erdemts/CanGateway/doc/Proje Detayları.docx

sysData.ioCheckDebounceTimer

sysData.currentDoorStates.DOOR_STATES.DOOR_1_STATE

sysData.SystemDoorCount

sensorList[count].START_COUNTING_QUERY_TRY_COUNT;

sysData.currentDoorStates.door_states

sysData.oldDoorStates.door_states

sysData.All_Doors_Closed

sysData.CAT_1_IN_TOTAL

sysData.currentDoorStates.DOOR_STATES.DOOR_1_STATE

,
