erdemts/CanGateway/doc/Tasarım Notları.docx

# 1. HARDWARE

  1.1. GPS
  1.2. SPI Flash (Sayısı ve özellikleri belirlenecek.)
  1.3. EEProm (2 adet 1 Mb ve 2 Mb uyumlu olacak.)
  1.4. 6x Digital Input (Girişlerden biri Input Capture özellikli olacak. Diğerleri On pin change özellikli olacak.)
  1.5. 2x Digital Output (TTL)
  1.6. 1x Relay
  1.7. Ethernet Modül
  1.8. 2x CanBus
  1.9. 1x RS232 (Bootloader)
  1.10. 1x RS485 (Kifi için)
  1.11. 1x SDCard
  1.12. 1x Uart Extension

Not: PIC32MX512F795L pin 68, 69, 70 Input Capture özelliklidir.

# 2. SOFTWARE

## 2.1. LOGLANMASI GEREKEN BİLGİLER

    2.1.1. Sensöre ulaşılamıyor.
    2.1.2. Sensor status.
    2.1.3. Veri gönderilemedi.
    2.1.4. Enerji geldi, gitti, düşük voltaj.
    2.1.5. Sensör diğer hatalar.
    2.1.6. Periyodik durum mesajı.

## 2.2. LOG YAPISI

    2.2.1. Tarih
    2.2.2. Saat
    2.2.3. Log Tipi
    2.2.4. Log Verisi

## 1. YOLCU SAYMA VERİSİ

Yolcu sayma verisi her kapı için ayrı ayrı gönderilir. Kapı açıldığında sayıma başlanır. Kapı kapatıldığında aşağıdaki formatta sayım verisi gönderilir.

  2.3. Kapı No 1 Byte (0,1,2)
  2.4. Kapının açılma zamanı 4 Byte (time_t)
  2.5. Kapının kapanma zamanı 4 Byte (time_t)
  2.6. Kategori 1 Binen Yolcu Sayısı 1 Byte
  2.7. Kategori 1 İnen Yolcu Sayısı 1 Byte
  2.8. Kategori 2 Binen Yolcu Sayısı 1 Byte
  2.9. Kategori 2 İnen Yolcu Sayısı 1 Byte

Toplam 13 byte.

typedef struct {

unsigned char doorNo;

time_t openTime;

time_t closeTime;

unsigned char Cat_1_In;

unsigned char Cat_1_Out;

unsigned char Cat_2_In;

unsigned char Cat_2_Out;

} COUNT_DATA_BUFFER_TYPE;

## 3. STATUS VERİSİ

Sensör veya canbus durum değişkenlerinde bir değişiklik olduğunda gönderilir.

  3.1. Zaman bilgisi 4Byte
  3.2. Status Tipi: Sensör veya Canbus statusu 1 Byte
  3.3. Kapı No: Sadece sensör status tipinde anlamlıdır. 1 Byte
  3.4. Status değişkeni 2 Byte

typedef struct {

time_t currentTime;

unsigned char statusType;

unsigned char doorNo;

unsigned short status;

} STATUS_DATA_BUFFER_TYPE;
