erdemts/CanGateway/Hardware/INNO_CAN/INNO_CAN_V1.1.brd

## EAGLE design Hardware/INNO_CAN/INNO_CAN_V1.1.brd (2018-05-25)

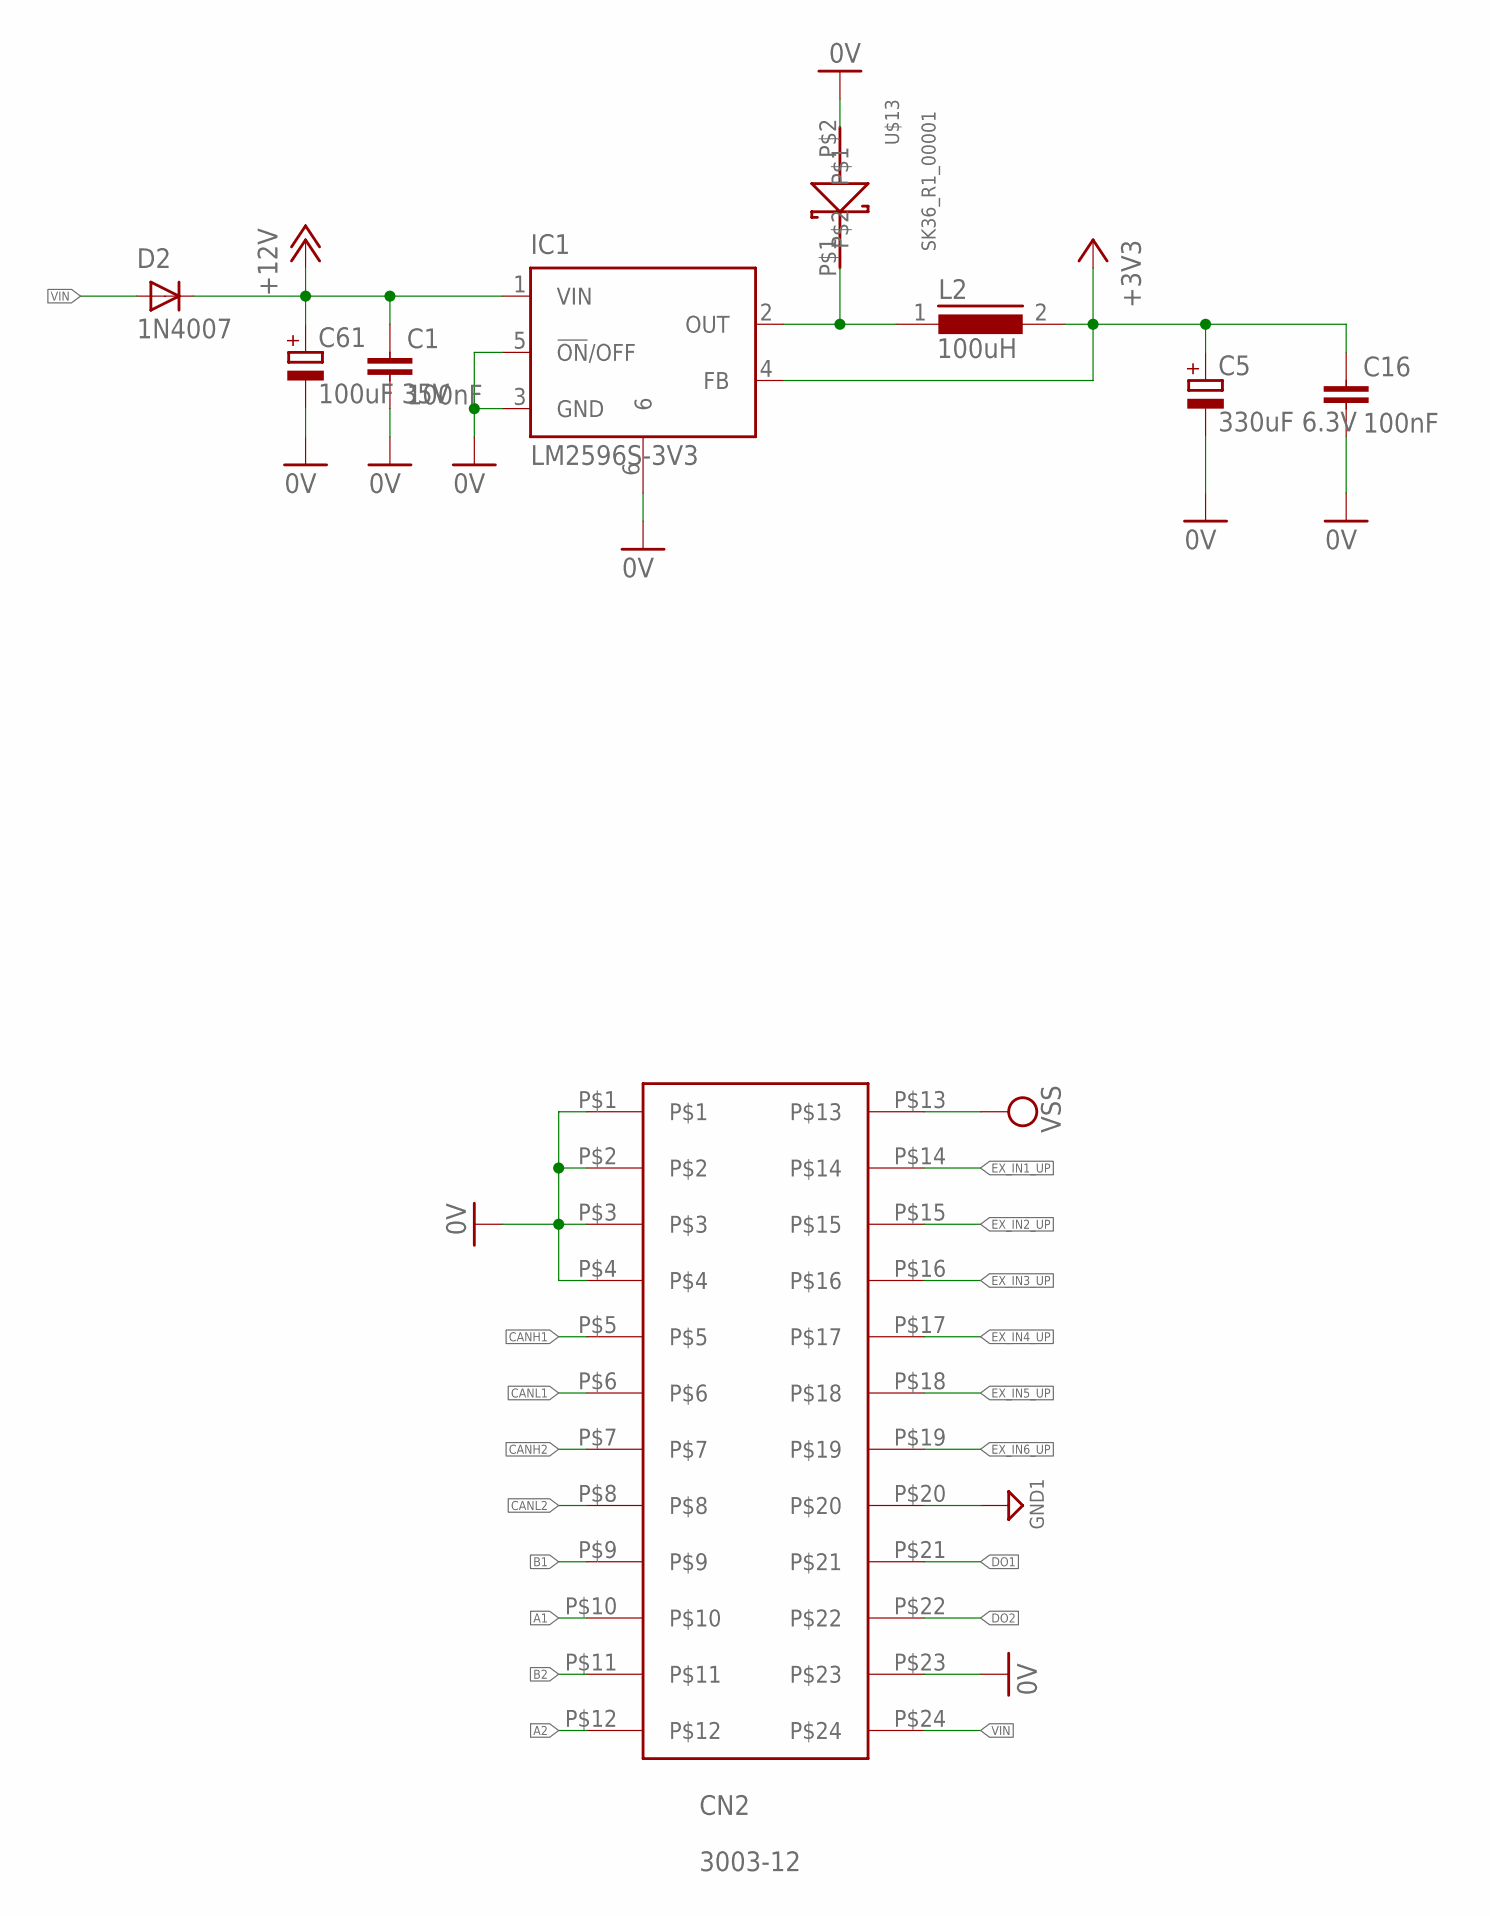
[picture p2: schematic INNO_CAN_V1.1.sch, sheet 1, POWER LAYER]

Parts:
C1, C16: 100nF; C0603
C5: 330uF 6.3V; E2,5-6
C61: 100uF 35V; E5-6
CN2: 3003-12
D2: 1N4007; SMA-DO214AC
IC1: LM2596S-3V3; TO263-5
L2: 100uH; DR127
U$13: SK36_R1_00001; SMC

Connections:
0V: C1.2, C5.-, C16.2, C61.-, CN2.P$1, CN2.P$2, CN2.P$3, CN2.P$4, CN2.P$23, IC1.3 (GND), IC1.5 (!ON!/OFF), IC1.6, U$13.P$2; also elsewhere on the board
+3V3: C5.+, C16.1, IC1.4 (FB), L2.2; also elsewhere on the board
+12V: C1.1, C61.+, D2.K (C), IC1.1 (VIN); also elsewhere on the board
A1: CN2.P$10; also elsewhere on the board
A2: CN2.P$12; also elsewhere on the board
B1: CN2.P$9; also elsewhere on the board
B2: CN2.P$11; also elsewhere on the board
CANH1: CN2.P$5; also elsewhere on the board
CANH2: CN2.P$7; also elsewhere on the board
CANL1: CN2.P$6; also elsewhere on the board
CANL2: CN2.P$8; also elsewhere on the board
DO1: CN2.P$21; also elsewhere on the board
DO2: CN2.P$22; also elsewhere on the board
EX_IN1_UP: CN2.P$14; also elsewhere on the board
EX_IN2_UP: CN2.P$15; also elsewhere on the board
EX_IN3_UP: CN2.P$16; also elsewhere on the board
EX_IN4_UP: CN2.P$17; also elsewhere on the board
EX_IN5_UP: CN2.P$18; also elsewhere on the board
EX_IN6_UP: CN2.P$19; also elsewhere on the board
GND1: CN2.P$20; also elsewhere on the board
unnamed: IC1.2 (OUT), L2.1, U$13.P$1
VIN: CN2.P$24, D2.A
VSS: CN2.P$13; also elsewhere on the board

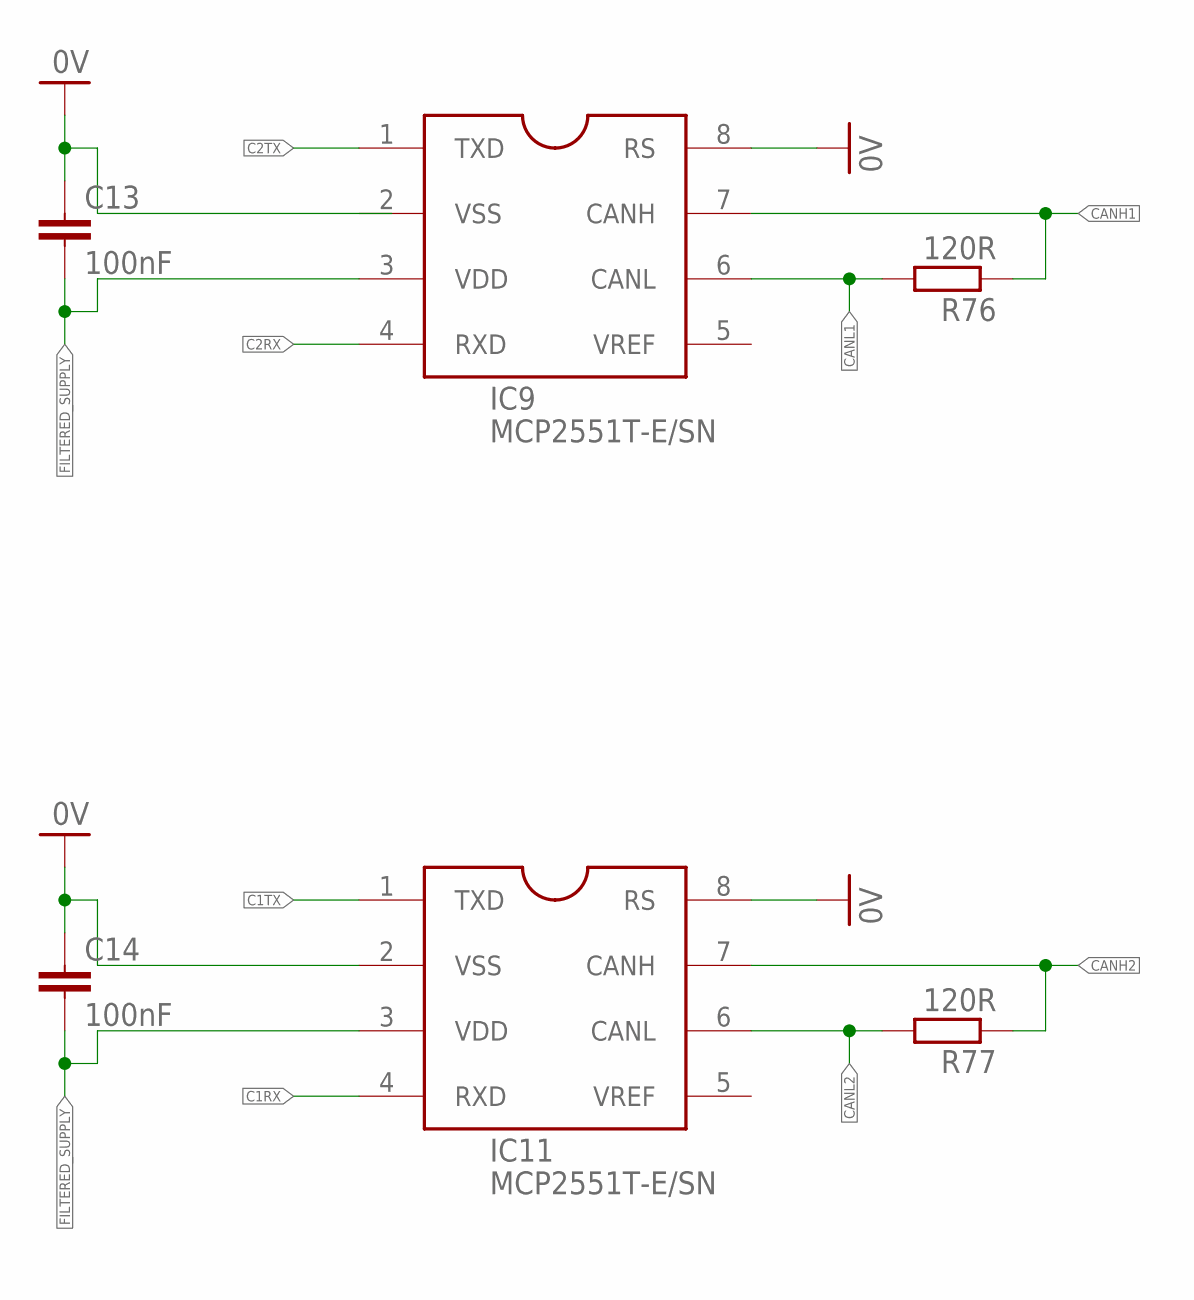
[picture p3: schematic INNO_CAN_V1.1.sch, sheet 2, CAN LAYER]

Parts:
C13, C14: 100nF; C0603K
IC9, IC11: MCP2551T-E/SN; SOIC08
R76, R77: 120R; R0603

Connections:
0V: C13.1, C14.1, IC9.8 (RS), IC11.2 (VSS), IC11.8 (RS); also elsewhere on the board
C1RX: IC11.4 (RXD); also elsewhere on the board
C1TX: IC11.1 (TXD); also elsewhere on the board
C2RX: IC9.4 (RXD); also elsewhere on the board
C2TX: IC9.1 (TXD); also elsewhere on the board
CANH1: IC9.7 (CANH), R76.1; also elsewhere on the board
CANH2: IC11.7 (CANH), R77.1; also elsewhere on the board
CANL1: IC9.6 (CANL), R76.2; also elsewhere on the board
CANL2: IC11.6 (CANL), R77.2; also elsewhere on the board
FILTERED_SUPPLY: C13.2, C14.2, IC9.3 (VDD), IC11.3 (VDD); also elsewhere on the board

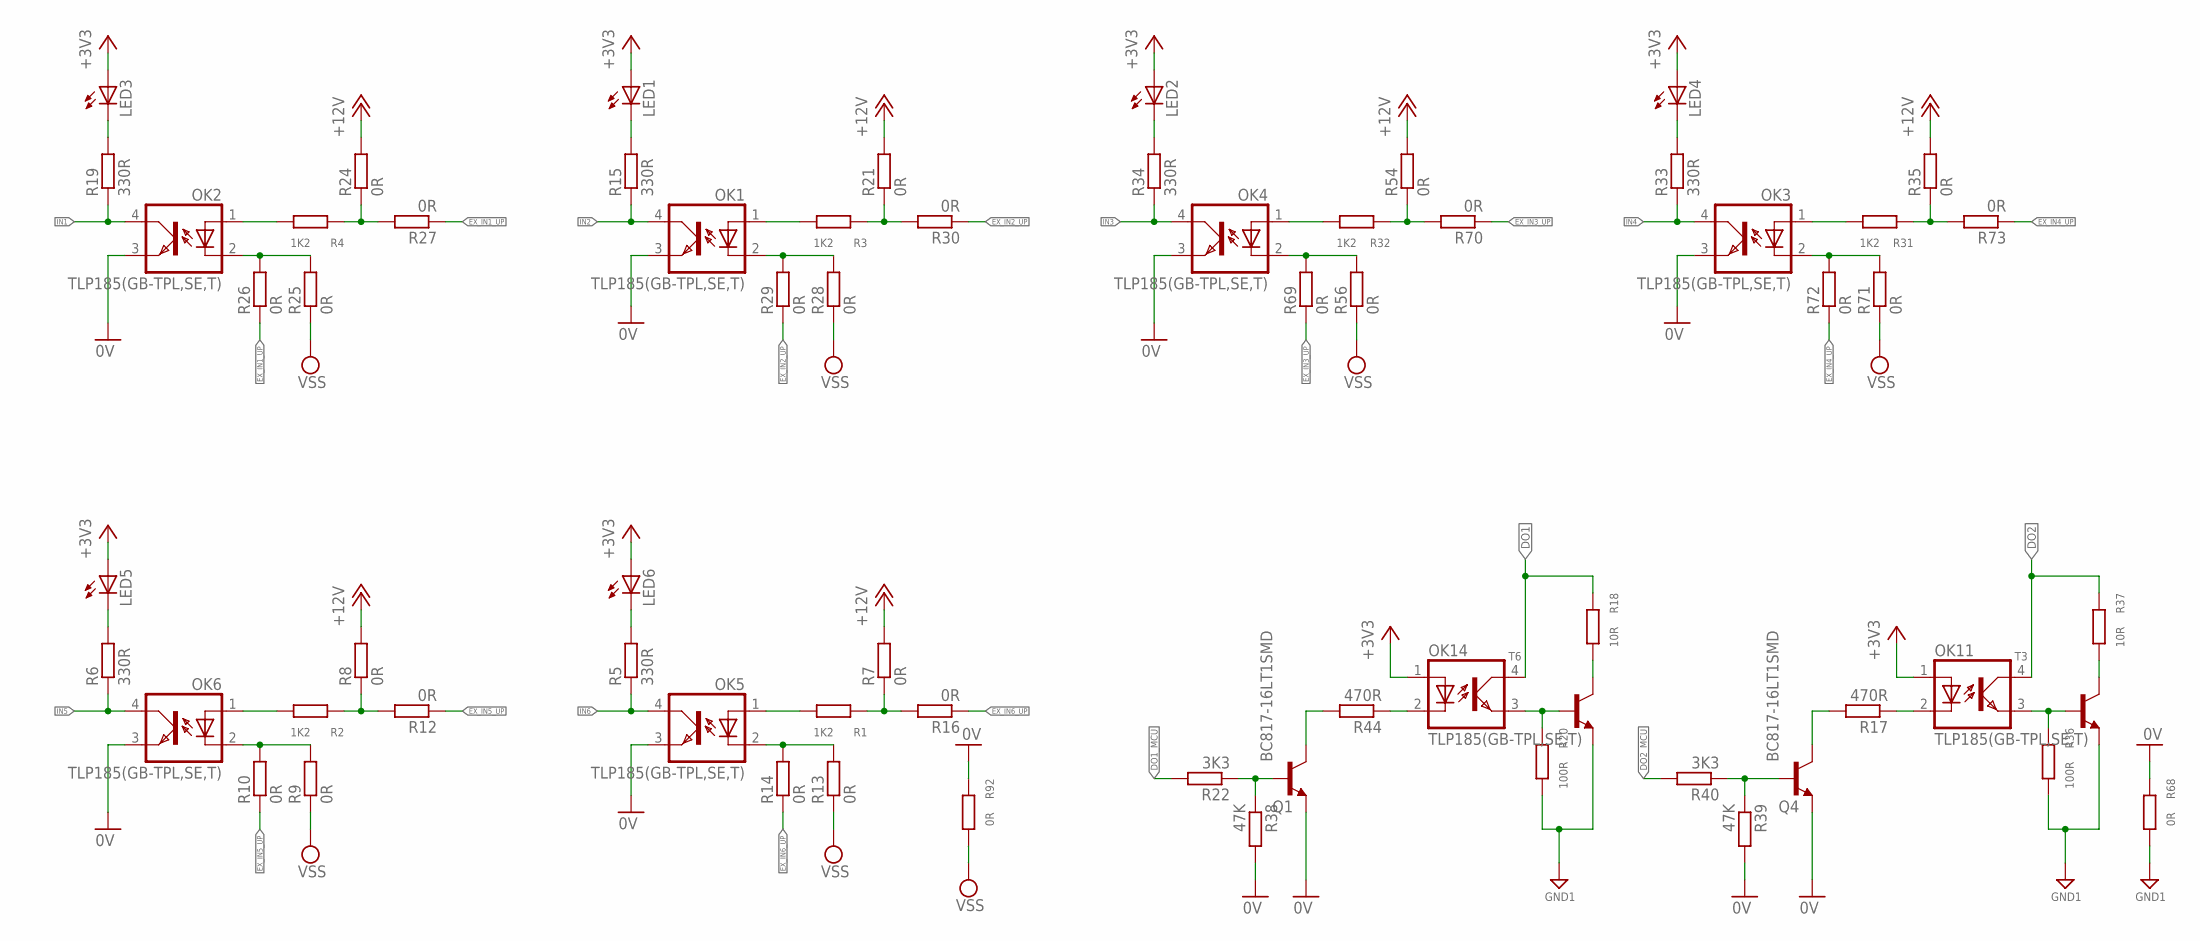
[picture p4: schematic INNO_CAN_V1.1.sch, sheet 3, PERIPHERLAS]

Parts:
LED1, LED2, LED3, LED4, LED5, LED6: LEDCHIPLED_0805; CHIPLED_0805
OK1, OK2, OK3, OK4, OK5, OK6, OK11, OK14: TLP185(GB-TPL,SE,T); SMD4
Q1, Q4: BC817-16LT1SMD; SOT23-BEC
R1, R2, R3, R4, R31, R32: 1K2; M0805
R5, R6, R15, R19, R33, R34: 330R; R0603
R7, R8, R9, R10, R12, R13, R14, R16, R21, R24, R25, R26, R27, R28, R29, R30, R35, R54, R56, R69, R70, R71, R72, R73: 0R; R0603
R17, R44: 470R; R0603
R18, R37: 10R; M0805
R20, R36: 100R; M0805
R22, R40: 3K3; R0603
R38, R39: 47K; R0603
R68, R92: 0R; M0805
T3, T6: BC817-16LT1-NPN-SOT23-BEC; SOT23-BEC

Connections:
0V: OK1.3 (EMIT), OK2.3 (EMIT), OK3.3 (EMIT), OK4.3 (EMIT), OK5.3 (EMIT), OK6.3 (EMIT), Q1.E, Q4.E, R38.2, R39.2, R68.1, R92.1; also elsewhere on the board
+3V3: LED1.A, LED2.A, LED3.A, LED4.A, LED5.A, LED6.A, OK11.1 (A), OK14.1 (A); also elsewhere on the board
+12V: R7.2, R8.2, R21.2, R24.2, R35.2, R54.2; also elsewhere on the board
DO1: OK14.4 (COL), R18.1; also elsewhere on the board
DO1_MCU: R22.2; also elsewhere on the board
DO2: OK11.4 (COL), R37.1; also elsewhere on the board
DO2_MCU: R40.2; also elsewhere on the board
EX_IN0_UP1: R3.1, R21.1, R30.2
EX_IN0_UP2: R31.1, R35.1, R73.2
EX_IN0_UP3: R1.1, R7.1, R16.2
EX_IN1_UP: R26.1, R27.1; also elsewhere on the board
EX_IN1_UP1: R4.1, R24.1, R27.2
EX_IN1_UP2: R32.1, R54.1, R70.2
EX_IN1_UP3: R2.1, R8.1, R12.2
EX_IN2_UP: R29.1, R30.1; also elsewhere on the board
EX_IN3_UP: R69.1, R70.1; also elsewhere on the board
EX_IN4_UP: R72.1, R73.1; also elsewhere on the board
EX_IN5_UP: R10.1, R12.1; also elsewhere on the board
EX_IN6_UP: R14.1, R16.1; also elsewhere on the board
GND1: R20.2, R36.2, R68.2, T3.E, T6.E; also elsewhere on the board
IN1: OK2.4 (COL), R19.1; also elsewhere on the board
IN2: OK1.4 (COL), R15.1; also elsewhere on the board
IN3: OK4.4 (COL), R34.1; also elsewhere on the board
IN4: OK3.4 (COL), R33.1; also elsewhere on the board
IN5: OK6.4 (COL), R6.1; also elsewhere on the board
IN6: OK5.4 (COL), R5.1; also elsewhere on the board
unnamed: OK1.1 (A), R3.2
unnamed: OK5.1 (A), R1.2
unnamed: OK2.1 (A), R4.2
unnamed: OK6.1 (A), R2.2
unnamed: OK2.2 (C), R25.2, R26.2
unnamed: OK6.2 (C), R9.2, R10.2
unnamed: OK5.2 (C), R13.2, R14.2
unnamed: OK1.2 (C), R28.2, R29.2
unnamed: LED5.C, R6.2
unnamed: LED6.C, R5.2
unnamed: OK11.2 (C), R17.1
unnamed: R37.2, T3.C
unnamed: OK11.3 (EMIT), R36.1, T3.B
unnamed: Q1.C, R44.2
unnamed: Q4.C, R17.2
unnamed: Q1.B, R22.1, R38.1
unnamed: OK3.1 (A), R31.2
unnamed: Q4.B, R39.1, R40.1
unnamed: OK4.1 (A), R32.2
unnamed: OK4.2 (C), R56.2, R69.2
unnamed: OK3.2 (C), R71.2, R72.2
unnamed: LED3.C, R19.2
unnamed: LED1.C, R15.2
unnamed: LED2.C, R34.2
unnamed: LED4.C, R33.2
unnamed: OK14.2 (C), R44.1
unnamed: R18.2, T6.C
unnamed: OK14.3 (EMIT), R20.1, T6.B
VSS: R9.1, R13.1, R25.1, R28.1, R56.1, R71.1, R92.2; also elsewhere on the board

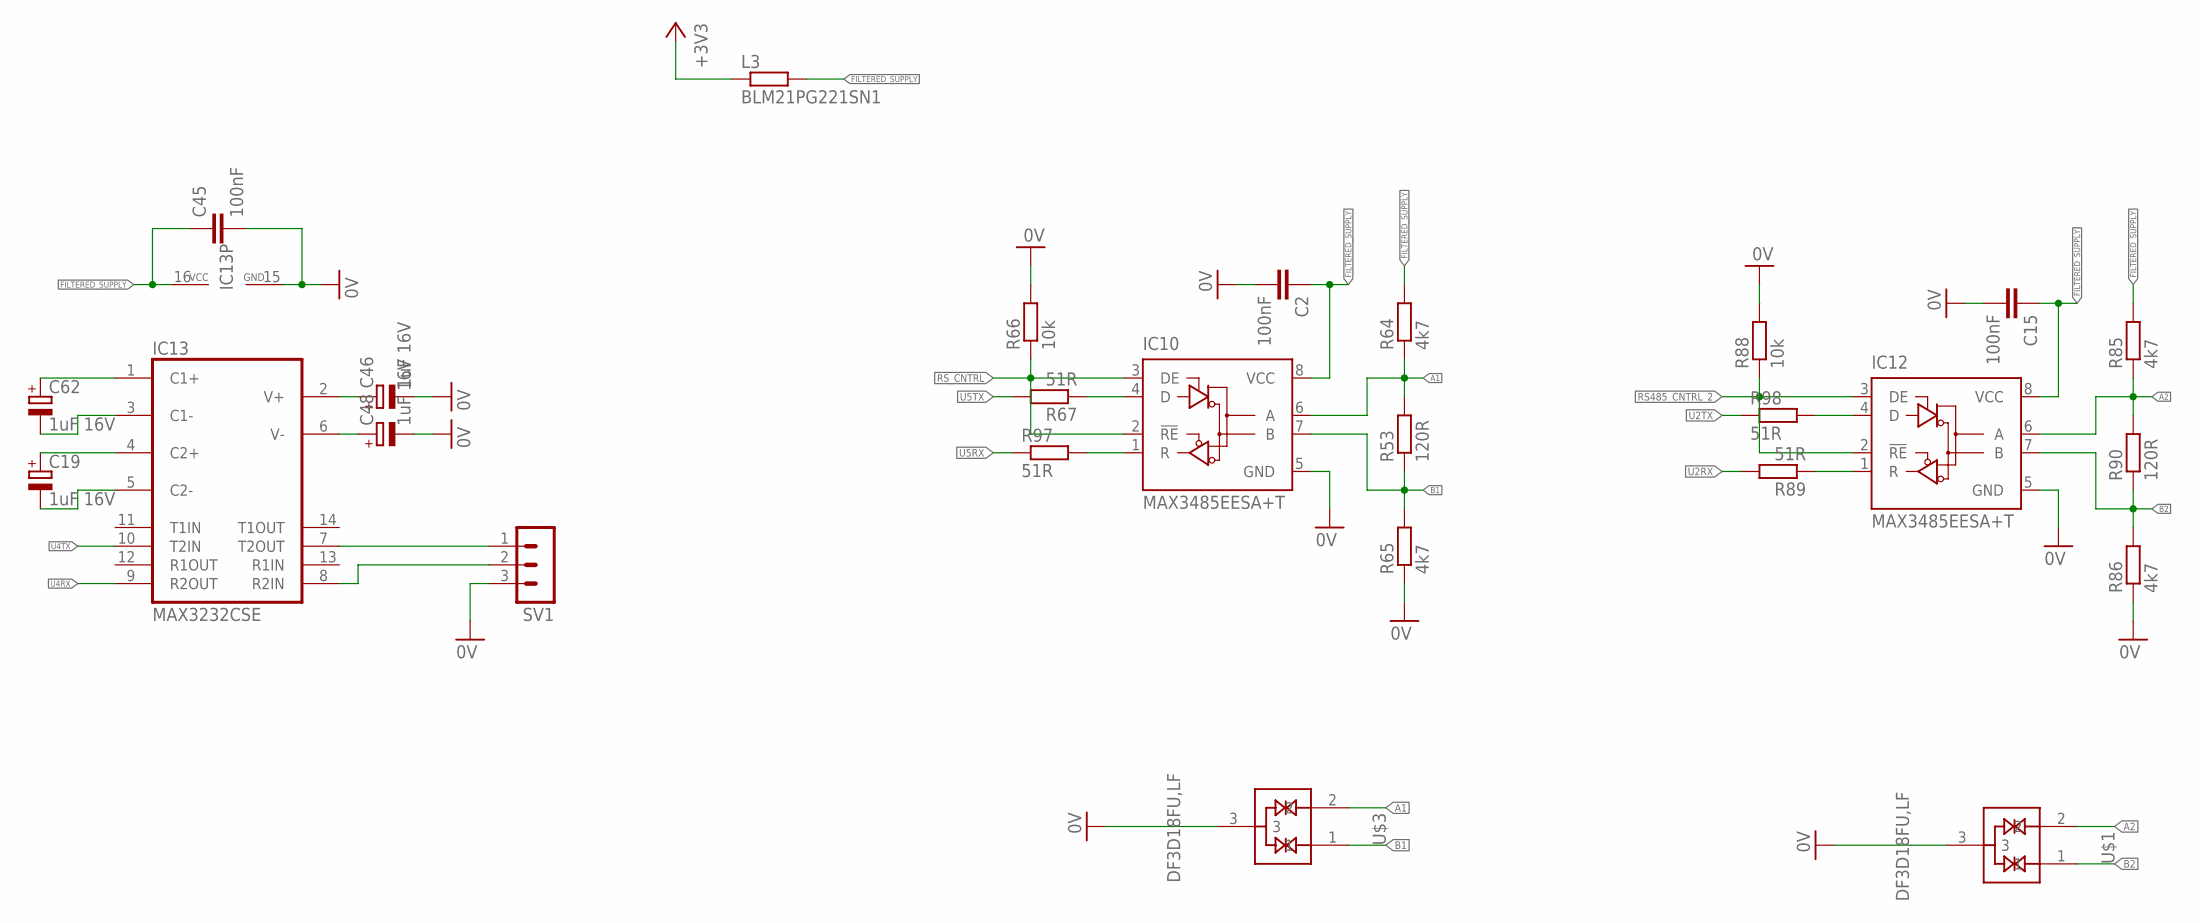
[picture p5: schematic INNO_CAN_V1.1.sch, sheet 4, RS-232 && RS-485]

Parts:
C2, C15, C45: 100nF; C0603
C19, C46, C48, C62: 1uF 16V; SMC_Z
IC10, IC12: MAX3485EESA+T; D_R-PDSO-G8
IC13: MAX3232CSE; SO16
L3: BLM21PG221SN1; R0805
R53, R90: 120R; R0603
R64, R65, R85, R86: 4k7; R0603
R66, R88: 10k; R0603
R67, R89, R97, R98: 51R; R0603
SV1: MA03-1
U$1, U$3: DF3D18FU,LF; SOT323

Connections:
0V: C2.2, C15.2, C45.2, C46.-, C48.-, IC10.5 (GND), IC12.5 (GND), IC13.15 (GND), R65.1, R66.2, R86.1, R88.2, SV1.3, U$1.3, U$3.3; also elsewhere on the board
+3V3: L3.1; also elsewhere on the board
A1: IC10.6 (A), R53.2, R64.1, U$3.2; also elsewhere on the board
A2: IC12.6 (A), R85.1, R90.2, U$1.2; also elsewhere on the board
B1: IC10.7 (B), R53.1, R65.2, U$3.1; also elsewhere on the board
B2: IC12.7 (B), R86.2, R90.1, U$1.1; also elsewhere on the board
FILTERED_SUPPLY: C2.1, C15.1, C45.1, IC10.8 (VCC), IC12.8 (VCC), IC13.16 (VCC), L3.2, R64.2, R85.2; also elsewhere on the board
unnamed: C62.-, IC13.3 (C1-)
unnamed: C19.+, IC13.4 (C2+)
unnamed: C46.+, IC13.2 (V+)
unnamed: C48.+, IC13.6 (V-)
unnamed: C62.+, IC13.1 (C1+)
unnamed: IC13.7 (T2OUT), SV1.1
unnamed: IC13.8 (R2IN), SV1.2
unnamed: C19.-, IC13.5 (C2-)
unnamed: IC10.1 (R), R97.2
unnamed: IC10.4 (D), R67.1
unnamed: IC12.1 (R), R89.1
unnamed: IC12.4 (D), R98.2
RS485_CNTRL_2: IC12.2 (!RE), IC12.3 (DE), R88.1; also elsewhere on the board
RS_CNTRL: IC10.2 (!RE), IC10.3 (DE), R66.1; also elsewhere on the board
U2RX: R89.2; also elsewhere on the board
U2TX: R98.1; also elsewhere on the board
U4RX: IC13.9 (R2OUT); also elsewhere on the board
U4TX: IC13.10 (T2IN); also elsewhere on the board
U5RX: R97.1; also elsewhere on the board
U5TX: R67.2; also elsewhere on the board

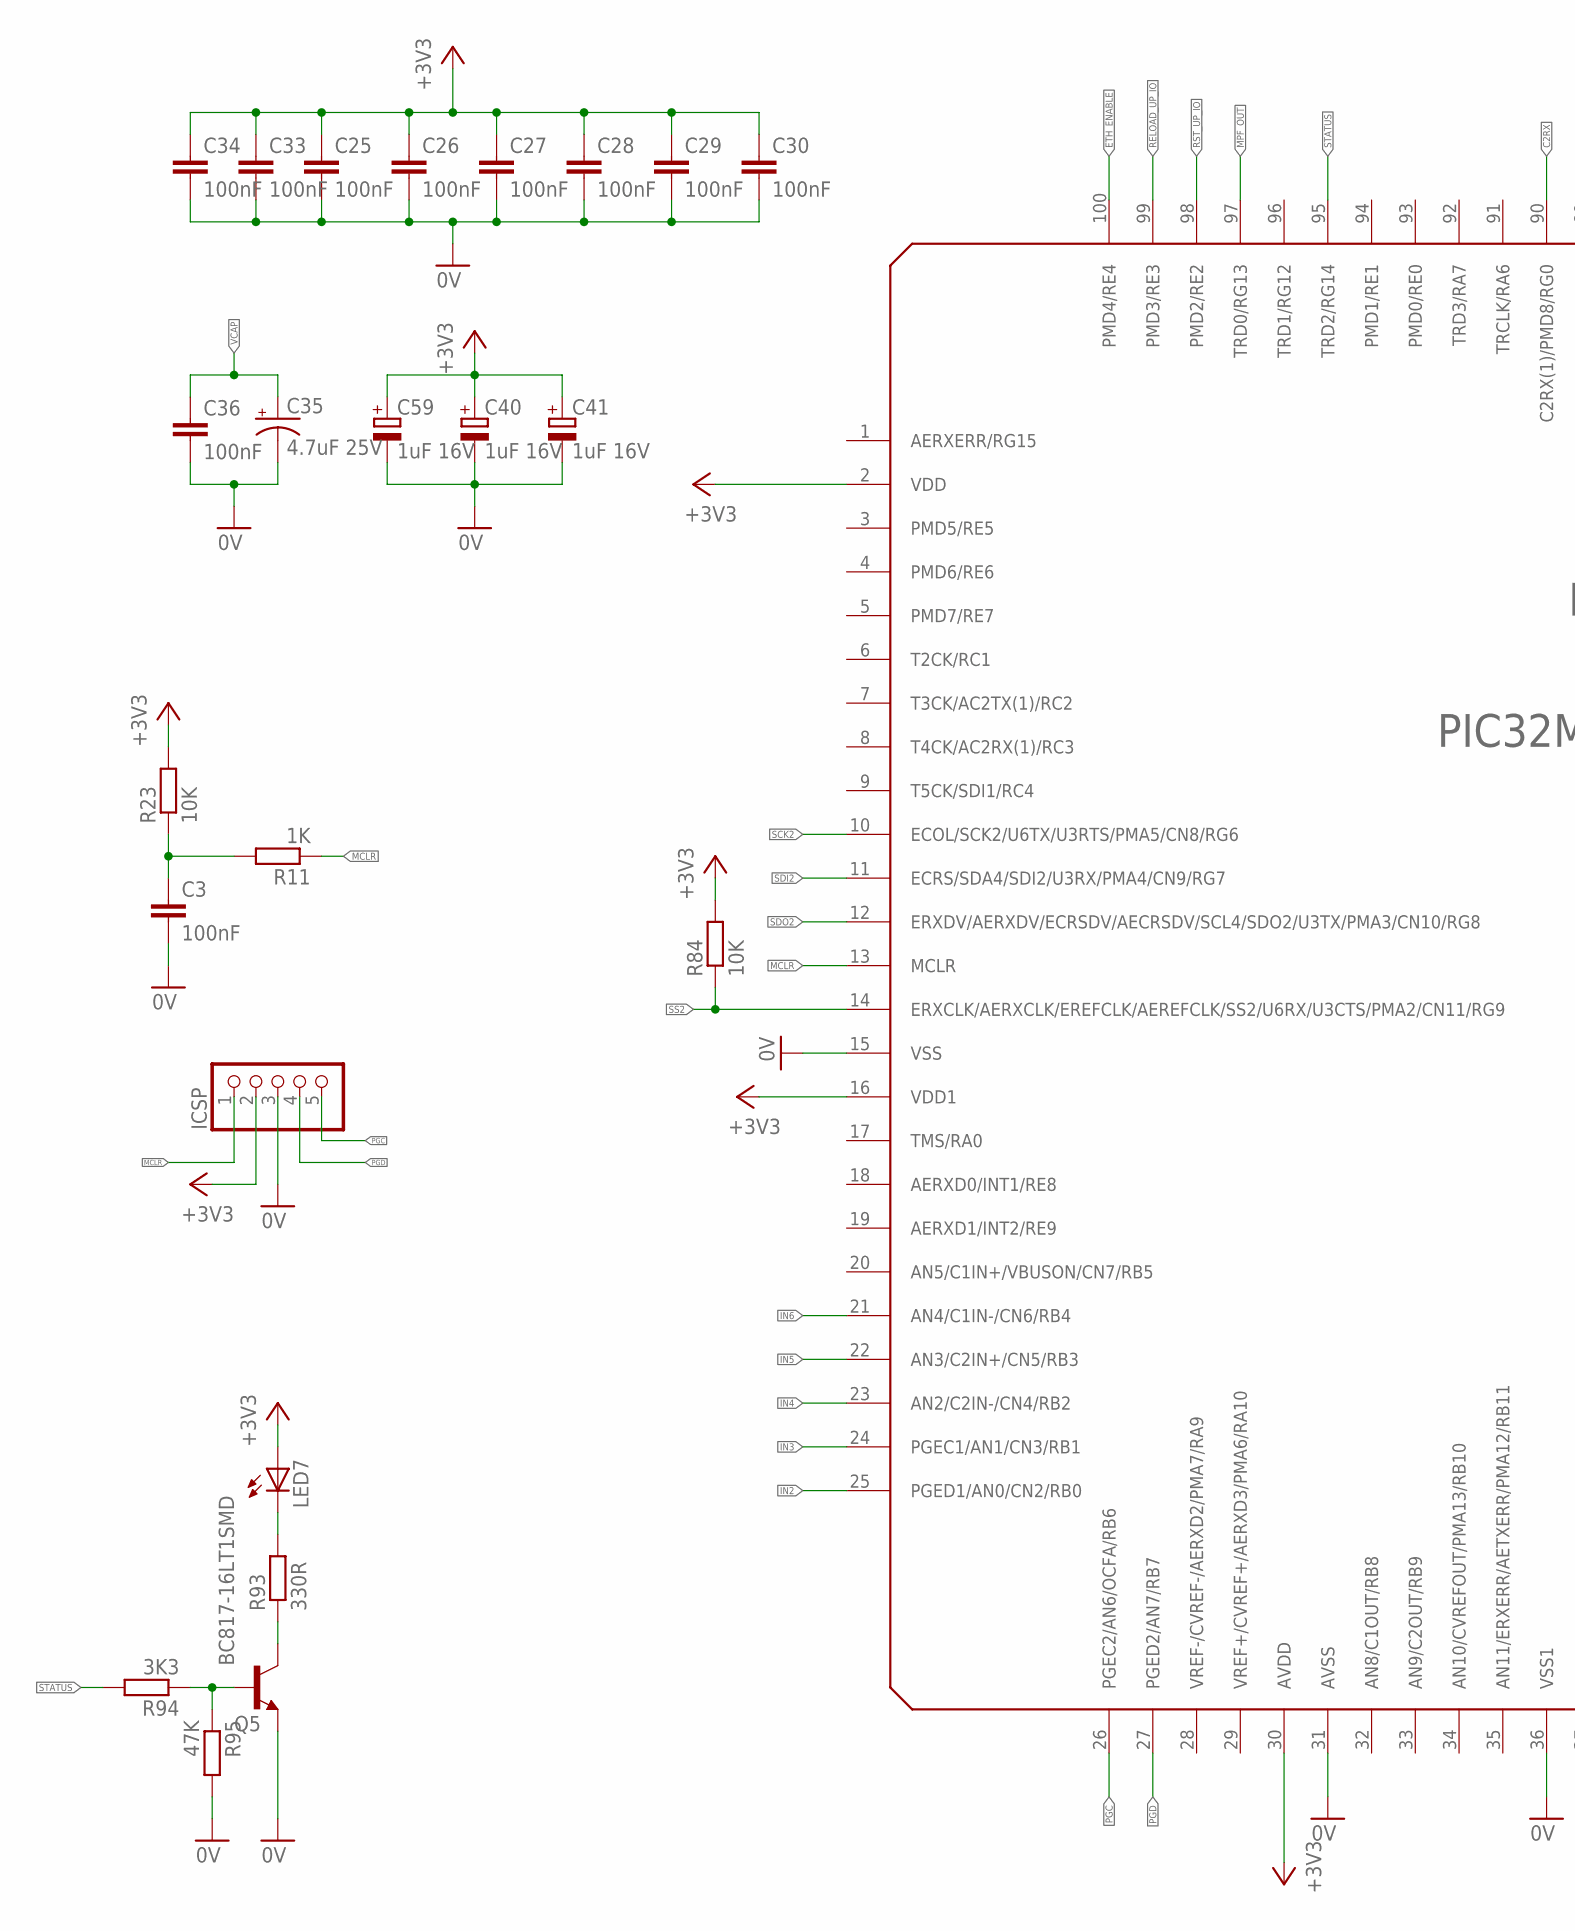
[picture p6: schematic INNO_CAN_V1.1.sch, sheet 5, MCU CONECTIONS, part in row 1, column 1]

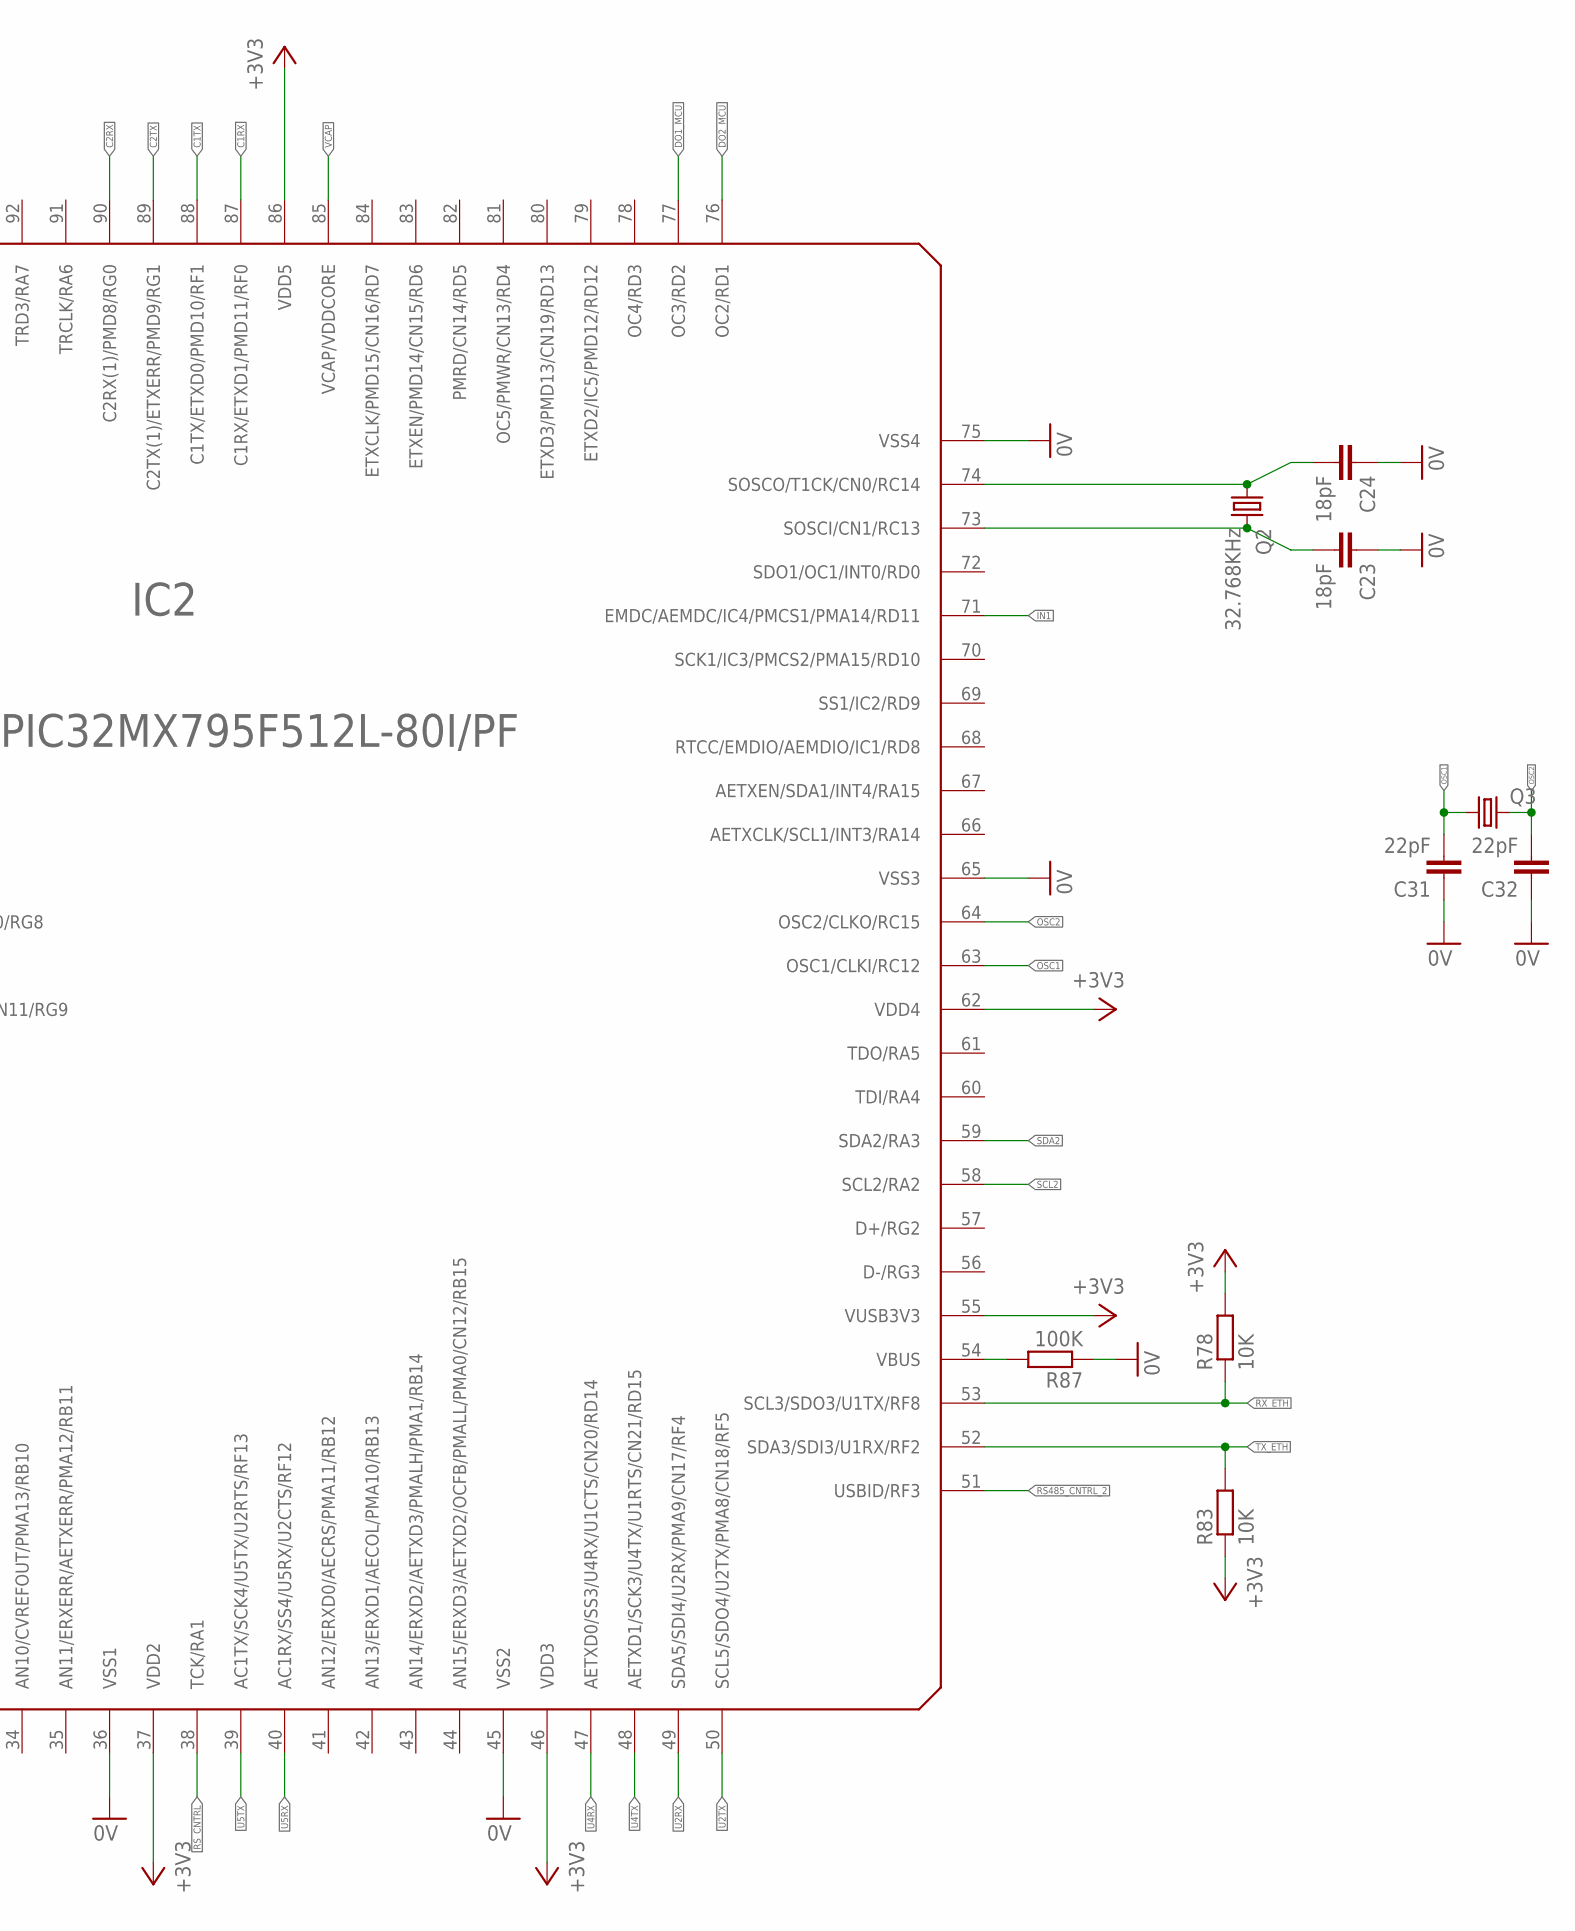
[picture p7: schematic INNO_CAN_V1.1.sch, sheet 5, MCU CONECTIONS, part in row 1, column 2]

Parts:
C3, C25, C26, C27, C28, C29, C30, C33, C34: 100nF; C0603K
C23, C24: 18pF; C0603
C31, C32: 22pF; C0805
C35: 4.7uF 25V; A/3216-18R
C36: 100nF; C0603
C40, C41, C59: 1uF 16V; SMC_Z
IC2: PIC32MX795F512L-80I/PF; TQFP100-14X14
ICSP: PINHD-1X5; 1X05
LED7: LEDCHIPLED_0805; CHIPLED_0805
Q2: 32.768KHz; TC26V
Q3: CRYSTALHC49UP; HC49UP
Q5: BC817-16LT1SMD; SOT23-BEC
R11: 1K; R0603
R23, R78, R83, R84: 10K; R0603
R87: 100K; R0603
R93: 330R; R0603
R94: 3K3; R0603
R95: 47K; R0603

Connections:
0V: C3.2, C23.1, C24.1, C25.2, C26.2, C27.2, C28.2, C29.2, C30.2, C31.1, C32.1, C33.2, C34.2, C35.-, C36.2, C40.-, C41.-, C59.-, IC2.15 (VSS), IC2.31 (AVSS), IC2.36 (VSS1), IC2.45 (VSS2), IC2.65 (VSS3), IC2.75 (VSS4), ICSP.3, Q5.E, R87.1, R95.2; also elsewhere on the board
+3V3: C25.1, C26.1, C27.1, C28.1, C29.1, C30.1, C33.1, C34.1, C40.+, C41.+, C59.+, IC2.2 (VDD), IC2.16 (VDD1), IC2.30 (AVDD), IC2.37 (VDD2), IC2.46 (VDD3), IC2.55 (VUSB3V3), IC2.62 (VDD4), IC2.86 (VDD5), ICSP.2, LED7.A, R23.2, R78.2, R83.1, R84.2; also elsewhere on the board
C1RX: IC2.87 (C1RX/ETXD1/PMD11/RF0); also elsewhere on the board
C1TX: IC2.88 (C1TX/ETXD0/PMD10/RF1); also elsewhere on the board
C2RX: IC2.90 (C2RX(1)/PMD8/RG0); also elsewhere on the board
C2TX: IC2.89 (C2TX(1)/ETXERR/PMD9/RG1); also elsewhere on the board
DO1_MCU: IC2.77 (OC3/RD2); also elsewhere on the board
DO2_MCU: IC2.76 (OC2/RD1); also elsewhere on the board
ETH_ENABLE: IC2.100 (PMD4/RE4); also elsewhere on the board
IN1: IC2.71 (EMDC/AEMDC/IC4/PMCS1/PMA14/RD11); also elsewhere on the board
IN2: IC2.25 (PGED1/AN0/CN2/RB0); also elsewhere on the board
IN3: IC2.24 (PGEC1/AN1/CN3/RB1); also elsewhere on the board
IN4: IC2.23 (AN2/C2IN-/CN4/RB2); also elsewhere on the board
IN5: IC2.22 (AN3/C2IN+/CN5/RB3); also elsewhere on the board
IN6: IC2.21 (AN4/C1IN-/CN6/RB4); also elsewhere on the board
MCLR: IC2.13 (MCLR), ICSP.1, R11.1
MPF_OUT: IC2.97 (TRD0/RG13); also elsewhere on the board
unnamed: C3.1, R11.2, R23.1
unnamed: LED7.C, R93.2
unnamed: Q5.B, R94.1, R95.1
unnamed: C23.2, IC2.73 (SOSCI/CN1/RC13), Q2.2
unnamed: Q5.C, R93.1
unnamed: C24.2, IC2.74 (SOSCO/T1CK/CN0/RC14), Q2.1
unnamed: IC2.54 (VBUS), R87.2
OSC1: C31.2, IC2.63 (OSC1/CLKI/RC12), Q3.1
OSC2: C32.2, IC2.64 (OSC2/CLKO/RC15), Q3.2
PGC: IC2.26 (PGEC2/AN6/OCFA/RB6), ICSP.5
PGD: IC2.27 (PGED2/AN7/RB7), ICSP.4
RELOAD_UP_IO: IC2.99 (PMD3/RE3); also elsewhere on the board
RS485_CNTRL_2: IC2.51 (USBID/RF3); also elsewhere on the board
RST_UP_IO: IC2.98 (PMD2/RE2); also elsewhere on the board
RS_CNTRL: IC2.38 (TCK/RA1); also elsewhere on the board
RX_ETH: IC2.53 (SCL3/SDO3/U1TX/RF8), R78.1; also elsewhere on the board
SCK2: IC2.10 (ECOL/SCK2/U6TX/U3RTS/PMA5/CN8/RG6); also elsewhere on the board
SCL2: IC2.58 (SCL2/RA2); also elsewhere on the board
SDA2: IC2.59 (SDA2/RA3); also elsewhere on the board
SDI2: IC2.11 (ECRS/SDA4/SDI2/U3RX/PMA4/CN9/RG7); also elsewhere on the board
SDO2: IC2.12 (ERXDV/AERXDV/ECRSDV/AECRSDV/SCL4/SDO2/U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); also elsewhere on the board
SS2: IC2.14 (ERXCLK/AERXCLK/EREFCLK/AEREFCLK/SS2/U6R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), R84.1; also elsewhere on the board
STATUS: IC2.95 (TRD2/RG14), R94.2
TX_ETH: IC2.52 (SDA3/SDI3/U1RX/RF2), R83.2; also elsewhere on the board
U2RX: IC2.49 (SDA5/SDI4/U2RX/PMA9/CN17/RF4); also elsewhere on the board
U2TX: IC2.50 (SCL5/SDO4/U2TX/PMA8/CN18/RF5); also elsewhere on the board
U4RX: IC2.47 (AETXD0/SS3/U4RX/U1CTS/CN20/RD14); also elsewhere on the board
U4TX: IC2.48 (AETXD1/SCK3/U4TX/U1RTS/CN21/RD15); also elsewhere on the board
U5RX: IC2.40 (AC1RX/SS4/U5RX/U2CTS/RF12); also elsewhere on the board
U5TX: IC2.39 (AC1TX/SCK4/U5TX/U2RTS/RF13); also elsewhere on the board
VCAP: C35.+, C36.1, IC2.85 (VCAP/VDDCORE)
