erdemts/CanGateway/Hardware/INNO_CAN/INNO_CAN_V1.1.brd

## EAGLE design Hardware/INNO_CAN/INNO_CAN_V1.1.brd (continued)

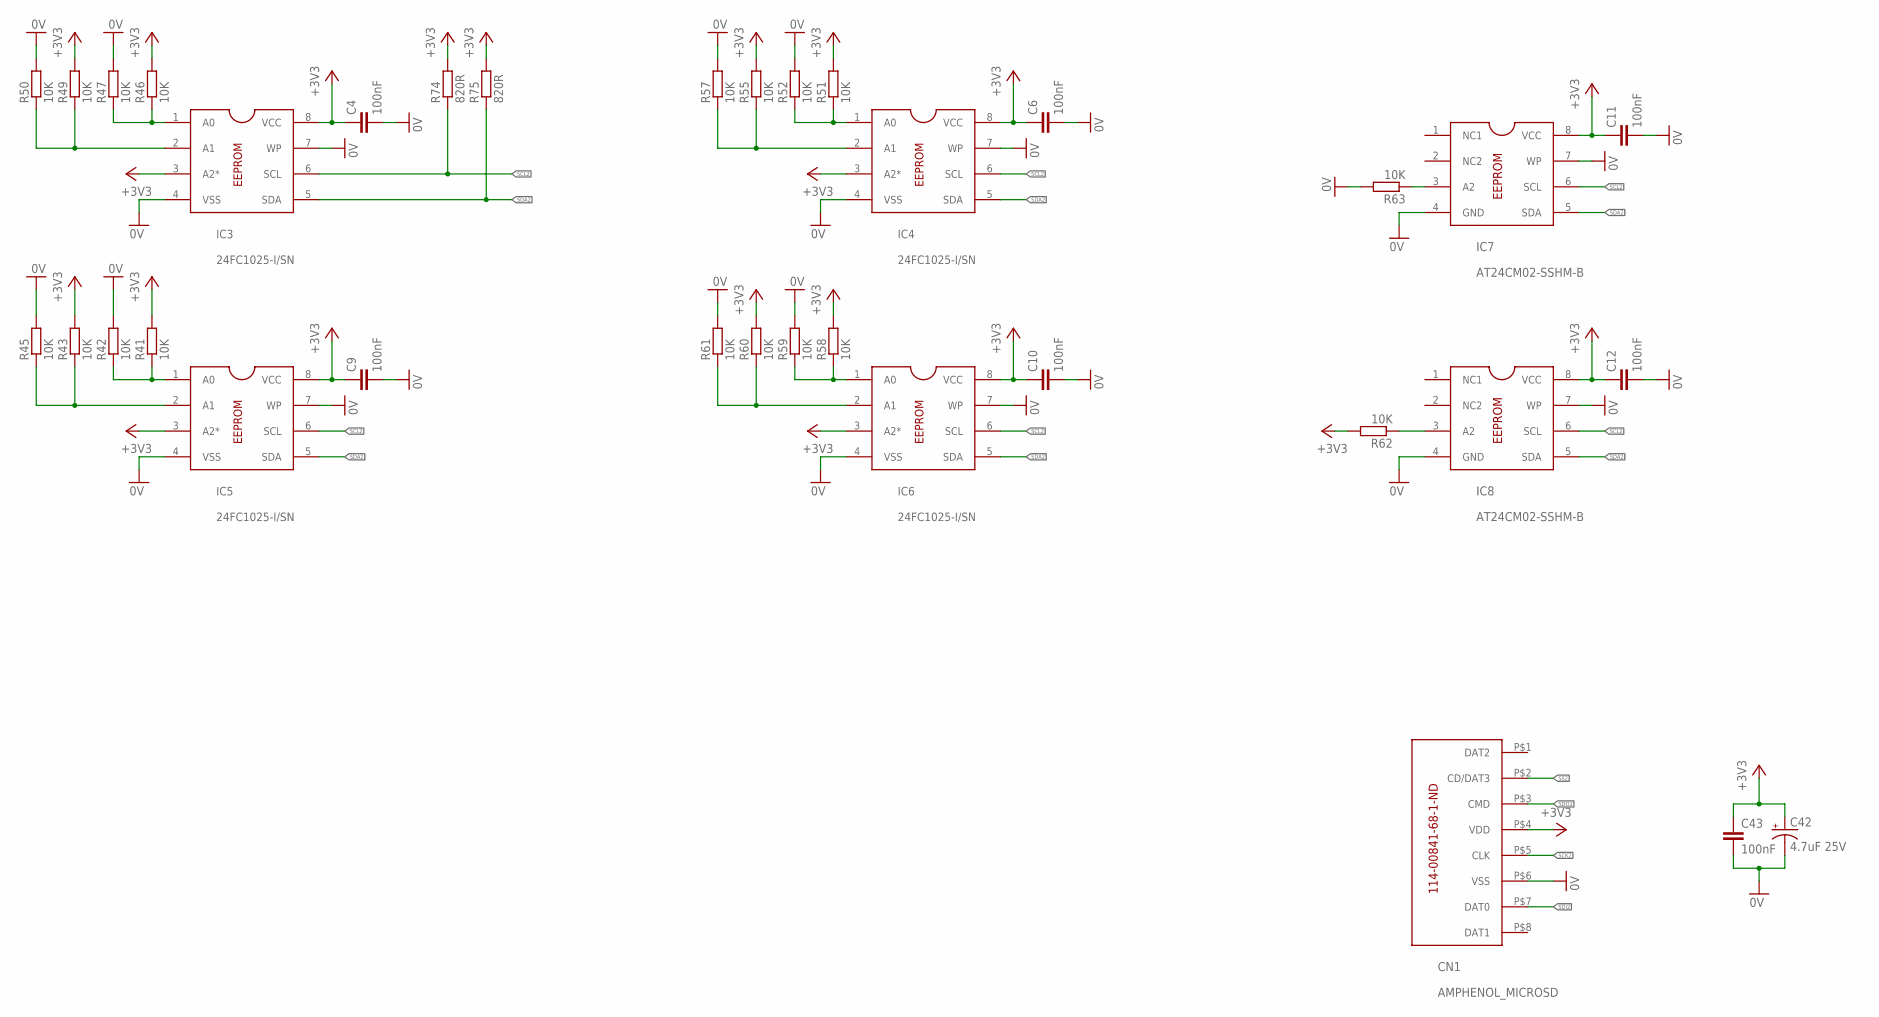
[picture p8: schematic INNO_CAN_V1.1.sch, sheet 6, MEMORY]

Parts:
C4, C6, C9, C10, C11, C12, C43: 100nF; C0603
C42: 4.7uF 25V; A/3216-18R
CN1: AMPHENOL_MICROSD
IC3, IC4, IC5, IC6: 24FC1025-I/SN; SOIC08
IC7, IC8: AT24CM02-SSHM-B; SOIC08
R41, R42, R43, R45, R46, R47, R49, R50, R51, R52, R55, R57, R58, R59, R60, R61, R62, R63: 10K; R0603
R74, R75: 820R; R0603

Connections:
0V: C4.2, C6.2, C9.2, C10.2, C11.2, C12.2, C42.-, C43.2, CN1.P$6 (VSS), IC3.4 (VSS), IC3.7 (WP), IC4.4 (VSS), IC4.7 (WP), IC5.4 (VSS), IC5.7 (WP), IC6.4 (VSS), IC6.7 (WP), IC7.4 (GND), IC7.7 (WP), IC8.4 (GND), IC8.7 (WP), R42.2, R45.2, R47.2, R50.2, R52.2, R57.2, R59.2, R61.2, R63.2; also elsewhere on the board
+3V3: C4.1, C6.1, C9.1, C10.1, C11.1, C12.1, C42.+, C43.1, CN1.P$4 (VDD), IC3.3 (A2*), IC3.8 (VCC), IC4.3 (A2*), IC4.8 (VCC), IC5.3 (A2*), IC5.8 (VCC), IC6.3 (A2*), IC6.8 (VCC), IC7.8 (VCC), IC8.8 (VCC), R41.2, R43.2, R46.2, R49.2, R51.2, R55.2, R58.2, R60.2, R62.2, R74.2, R75.2; also elsewhere on the board
unnamed: IC5.1 (A0), R41.1, R42.1
unnamed: IC5.2 (A1), R43.1, R45.1
unnamed: IC3.1 (A0), R46.1, R47.1
unnamed: IC3.2 (A1), R49.1, R50.1
unnamed: IC4.2 (A1), R55.1, R57.1
unnamed: IC4.1 (A0), R51.1, R52.1
unnamed: IC6.1 (A0), R58.1, R59.1
unnamed: IC6.2 (A1), R60.1, R61.1
unnamed: IC8.3 (A2), R62.1
unnamed: IC7.3 (A2), R63.1
SCK2: CN1.P$5 (CLK); also elsewhere on the board
SCL2: IC3.6 (SCL), IC4.6 (SCL), IC5.6 (SCL), IC6.6 (SCL), IC7.6 (SCL), IC8.6 (SCL), R74.1; also elsewhere on the board
SDA2: IC3.5 (SDA), IC4.5 (SDA), IC5.5 (SDA), IC6.5 (SDA), IC7.5 (SDA), IC8.5 (SDA), R75.1; also elsewhere on the board
SDI2: CN1.P$7 (DAT0); also elsewhere on the board
SDO2: CN1.P$3 (CMD); also elsewhere on the board
SS2: CN1.P$2 (CD/DAT3); also elsewhere on the board

Notes on the sheet:
114-00841-68-1-ND

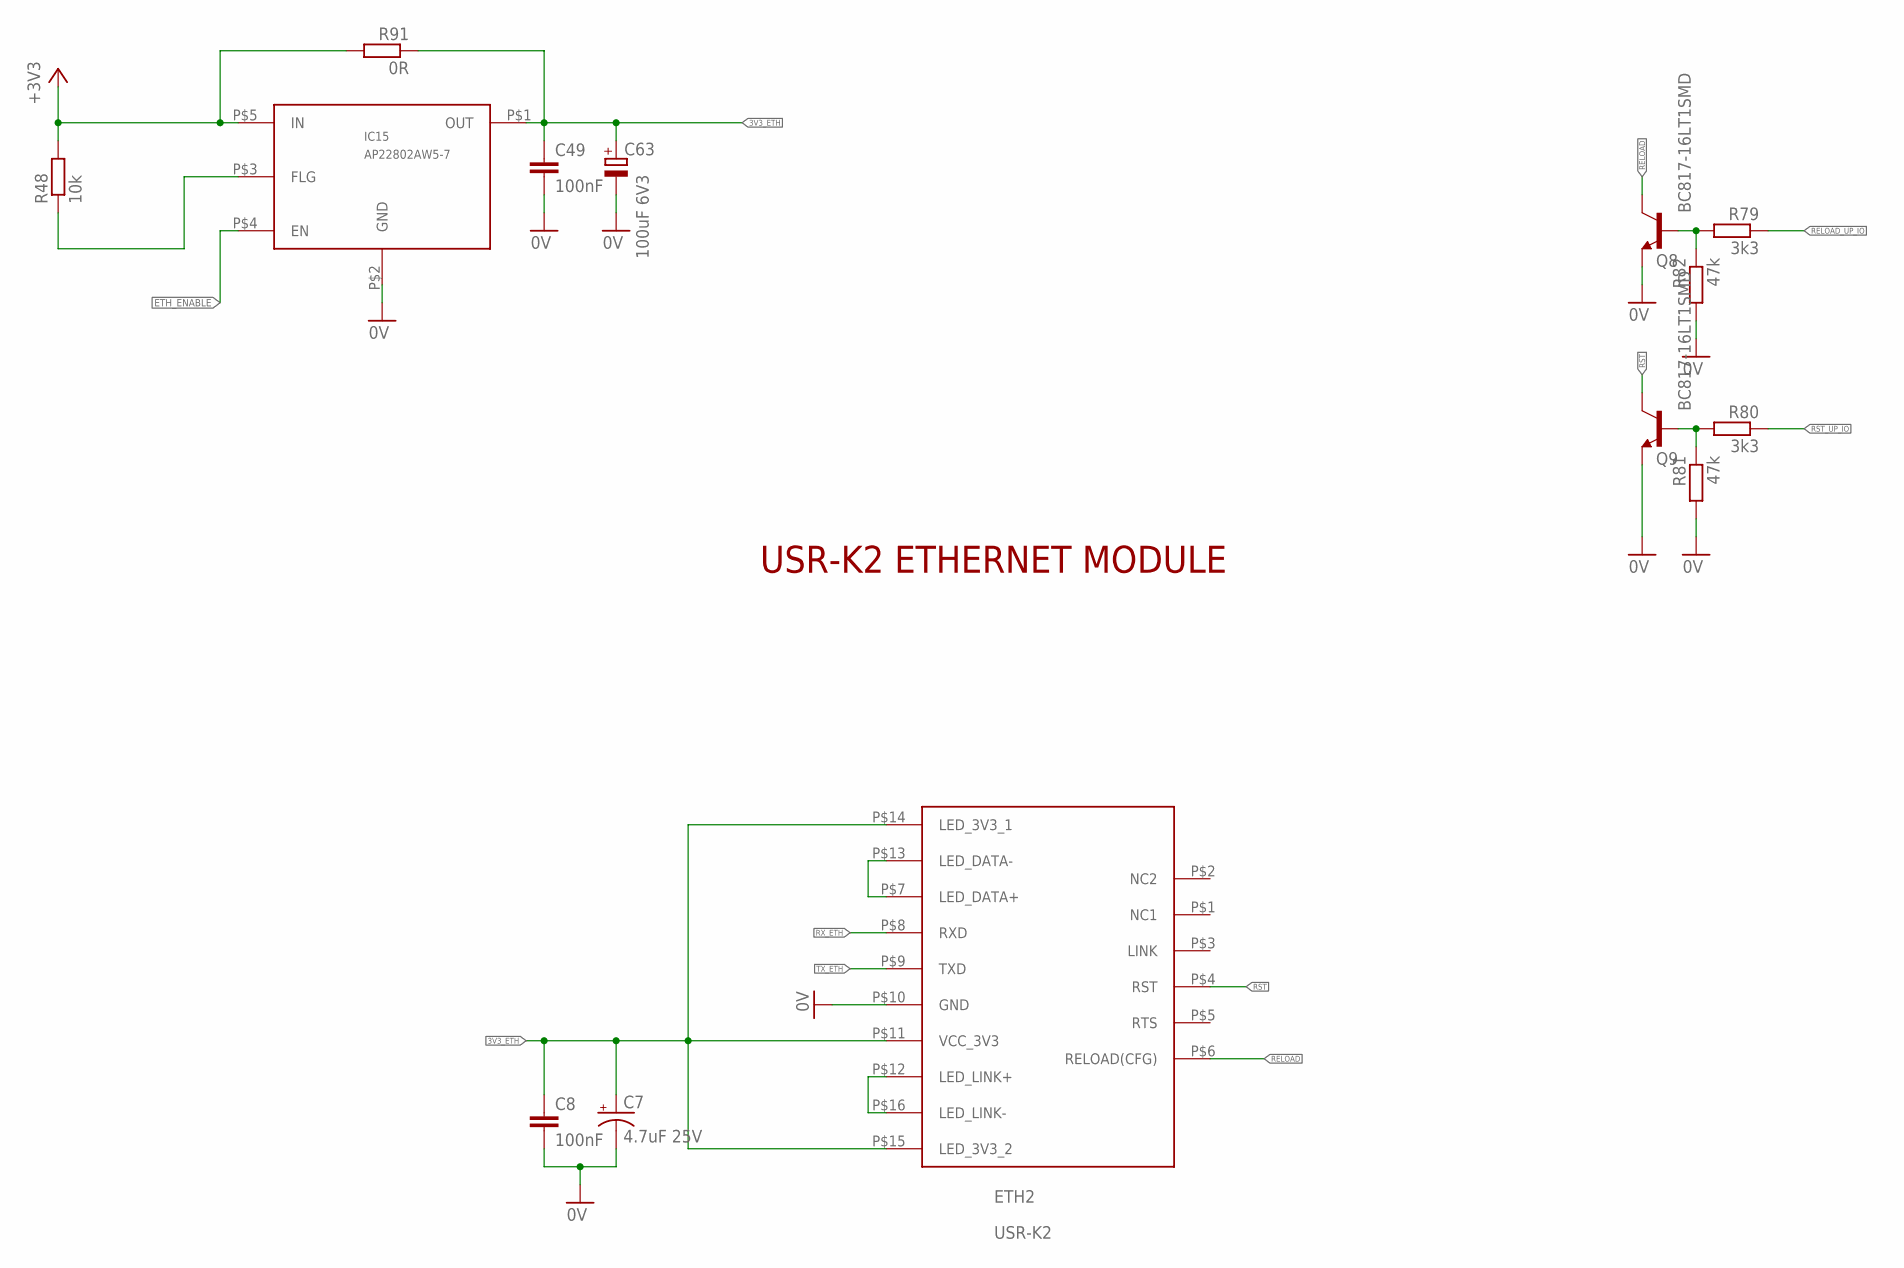
[picture p9: schematic INNO_CAN_V1.1.sch, sheet 7, ETHERNET]

Parts:
C7: 4.7uF 25V; A/3216-18R
C8, C49: 100nF; C0603
C63: 100uF 6V3; E5-5
ETH2: USR-K2
IC15: AP22802AW5-7; SOT23-5L
Q8, Q9: BC817-16LT1SMD; SOT23-BEC
R48: 10k; R0603
R79, R80: 3k3; R0805
R81, R82: 47k; R0805
R91: 0R; R0805

Connections:
0V: C7.-, C8.2, C49.2, C63.-, ETH2.P$10 (GND), IC15.P$2 (GND), Q8.E, Q9.E, R81.2, R82.2; also elsewhere on the board
3V3_ETH: C7.+, C8.1, C49.1, C63.+, ETH2.P$11 (VCC_3V3), ETH2.P$14 (LED_3V3_1), ETH2.P$15 (LED_3V3_2), IC15.P$1 (OUT), R91.1
+3V3: IC15.P$5 (IN), R48.2, R91.2; also elsewhere on the board
ETH_ENABLE: IC15.P$4 (EN); also elsewhere on the board
unnamed: ETH2.P$12 (LED_LINK+), ETH2.P$16 (LED_LINK-)
unnamed: ETH2.P$7 (LED_DATA+), ETH2.P$13 (LED_DATA-)
unnamed: IC15.P$3 (FLG), R48.1
RELOAD: ETH2.P$6 (RELOAD(CFG)), Q8.C
RELOAD_UP_IO: R79.1; also elsewhere on the board
RST: ETH2.P$4 (RST), Q9.C
RST_UP_IO: R80.1; also elsewhere on the board
RX_ETH: ETH2.P$8 (RXD); also elsewhere on the board
TXD2: Q8.B, R79.2, R82.1
TXD3: Q9.B, R80.2, R81.1
TX_ETH: ETH2.P$9 (TXD); also elsewhere on the board

Notes on the sheet:
USR-K2 ETHERNET MODULE

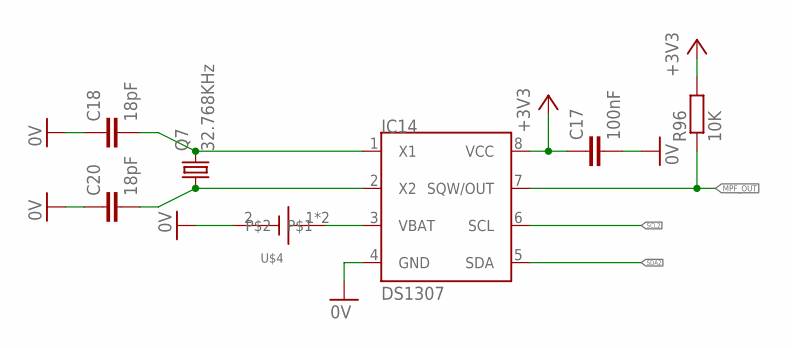
[picture p10: schematic INNO_CAN_V1.1.sch, sheet 8, RTC LAYER]

Parts:
C17: 100nF; C0603K
C18, C20: 18pF; C0603
IC14: DS1307; SOIC-8
Q7: 32.768KHz; TC26V
R96: 10K; R0603
U$4: BATTERY

Connections:
0V: C17.2, C18.1, C20.1, IC14.4 (GND), U$4.2; also elsewhere on the board
+3V3: C17.1, IC14.8 (VCC), R96.2; also elsewhere on the board
MPF_OUT: IC14.7 (SQW/OUT), R96.1; also elsewhere on the board
unnamed: C18.2, IC14.1 (X1), Q7.2
unnamed: C20.2, IC14.2 (X2), Q7.1
unnamed: IC14.3 (VBAT), U$4.1, U$4.3
SCL2: IC14.6 (SCL); also elsewhere on the board
SDA2: IC14.5 (SDA); also elsewhere on the board

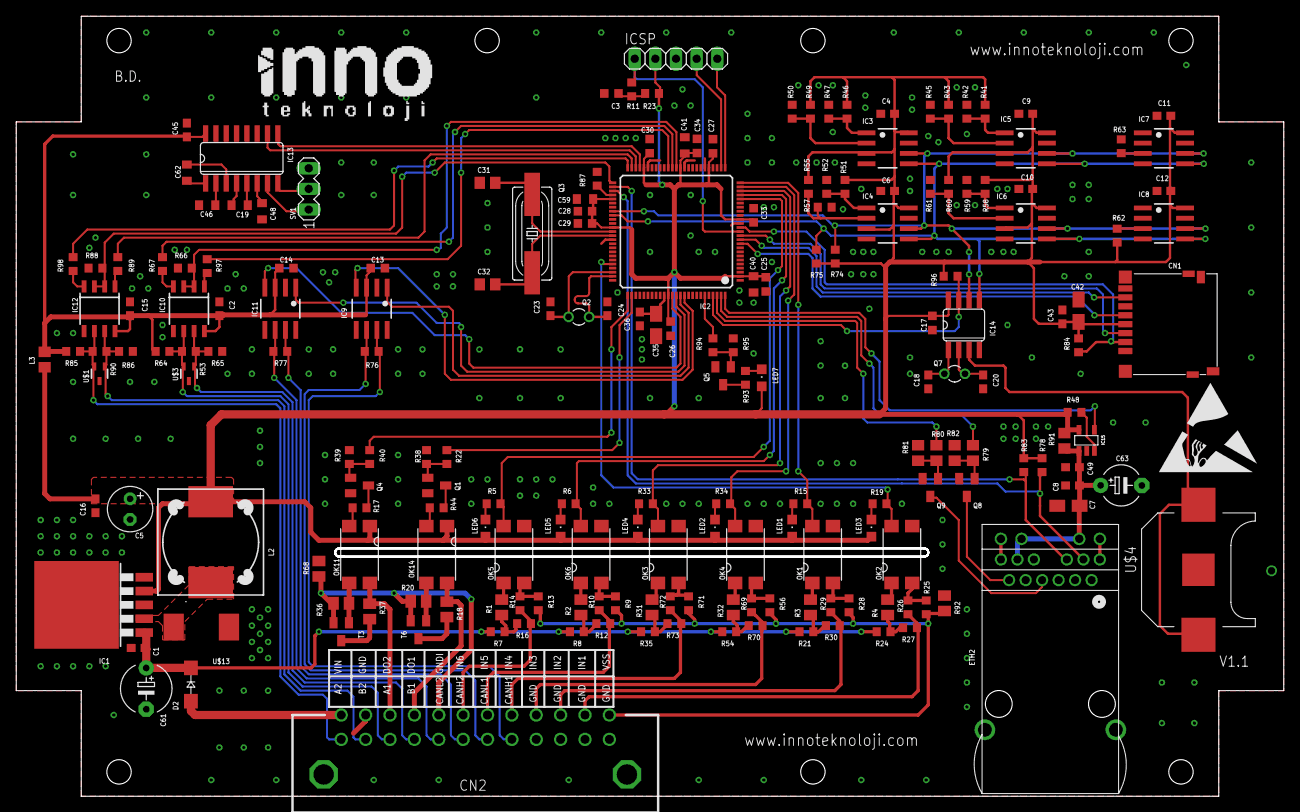
[picture p11: board INNO_CAN_V1.1.brd from above]

Board: 2 copper layers, 156.0 x 96.0 mm, 196 parts (0 on the bottom side), 137 nets.
