erdemts/CanGateway/firmware/src/system_config/innoGateway2_base/system_config.h

/*******************************************************************************
  MPLAB Harmony System Configuration Header

  File Name:
    system_config.h

  Summary:
    Build-time configuration header for the system defined by this MPLAB Harmony
    project.

  Description:
    An MPLAB Project may have multiple configurations.  This file defines the
    build-time options for a single configuration.

  Remarks:
    This configuration header must not define any prototypes or data
    definitions (or include any files that do).  It only provides macro
    definitions for build-time configuration options that are not instantiated
    until used by another MPLAB Harmony module or application.

    Created with MPLAB Harmony Version 2.04
*******************************************************************************/

// DOM-IGNORE-BEGIN
/*******************************************************************************
Copyright (c) 2013-2015 released Microchip Technology Inc.  All rights reserved.

Microchip licenses to you the right to use, modify, copy and distribute
Software only when embedded on a Microchip microcontroller or digital signal
controller that is integrated into your product or third party product
(pursuant to the sublicense terms in the accompanying license agreement).

You should refer to the license agreement accompanying this Software for
additional information regarding your rights and obligations.

SOFTWARE AND DOCUMENTATION ARE PROVIDED AS IS WITHOUT WARRANTY OF ANY KIND,
EITHER EXPRESS OR IMPLIED, INCLUDING WITHOUT LIMITATION, ANY WARRANTY OF
MERCHANTABILITY, TITLE, NON-INFRINGEMENT AND FITNESS FOR A PARTICULAR PURPOSE.
IN NO EVENT SHALL MICROCHIP OR ITS LICENSORS BE LIABLE OR OBLIGATED UNDER
CONTRACT, NEGLIGENCE, STRICT LIABILITY, CONTRIBUTION, BREACH OF WARRANTY, OR
OTHER LEGAL EQUITABLE THEORY ANY DIRECT OR INDIRECT DAMAGES OR EXPENSES
INCLUDING BUT NOT LIMITED TO ANY INCIDENTAL, SPECIAL, INDIRECT, PUNITIVE OR
CONSEQUENTIAL DAMAGES, LOST PROFITS OR LOST DATA, COST OF PROCUREMENT OF
SUBSTITUTE GOODS, TECHNOLOGY, SERVICES, OR ANY CLAIMS BY THIRD PARTIES
(INCLUDING BUT NOT LIMITED TO ANY DEFENSE THEREOF), OR OTHER SIMILAR COSTS.
*******************************************************************************/
// DOM-IGNORE-END

#ifndef _SYSTEM_CONFIG_H
#define _SYSTEM_CONFIG_H

// *****************************************************************************
// *****************************************************************************
// Section: Included Files
// *****************************************************************************
// *****************************************************************************
/*  This section Includes other configuration headers necessary to completely
    define this configuration.
*/
#include "bsp.h"


// DOM-IGNORE-BEGIN
#ifdef __cplusplus  // Provide C++ Compatibility

extern "C" {

#endif
// DOM-IGNORE-END

// *****************************************************************************
// *****************************************************************************
// Section: System Service Configuration
// *****************************************************************************
// *****************************************************************************
// *****************************************************************************
/* Common System Service Configuration Options
*/
#define SYS_VERSION_STR           "2.04"
#define SYS_VERSION               20400

// *****************************************************************************
/* Clock System Service Configuration Options
*/
#define SYS_CLK_FREQ                        80000000ul
#define SYS_CLK_BUS_PERIPHERAL_1            80000000ul
#define SYS_CLK_UPLL_BEFORE_DIV2_FREQ       48000000ul
#define SYS_CLK_CONFIG_PRIMARY_XTAL         8000000ul
#define SYS_CLK_CONFIG_SECONDARY_XTAL       32768ul
   
/*** Ports System Service Configuration ***/
#define SYS_PORT_AD1PCFG        ~0xffc0
#define SYS_PORT_CNPUE          0x0
#define SYS_PORT_CNEN           0x7c
#define SYS_PORT_A_TRIS         0xFFFD
#define SYS_PORT_A_LAT          0x0000
#define SYS_PORT_A_ODC          0x0000

#define SYS_PORT_B_TRIS         0xFFFF
#define SYS_PORT_B_LAT          0x0000
#define SYS_PORT_B_ODC          0x0000

#define SYS_PORT_C_TRIS         0xFFFF
#define SYS_PORT_C_LAT          0x0000
#define SYS_PORT_C_ODC          0x0000

#define SYS_PORT_D_TRIS         0xFFF9
#define SYS_PORT_D_LAT          0x0000
#define SYS_PORT_D_ODC          0x0000

#define SYS_PORT_E_TRIS         0xFFE3
#define SYS_PORT_E_LAT          0x0010
#define SYS_PORT_E_ODC          0x0000

#define SYS_PORT_F_TRIS         0xFFF7
#define SYS_PORT_F_LAT          0x0000
#define SYS_PORT_F_ODC          0x0000

#define SYS_PORT_G_TRIS         0xBDFF
#define SYS_PORT_G_LAT          0x0000
#define SYS_PORT_G_ODC          0x0000


/*** Interrupt System Service Configuration ***/
#define SYS_INT                     true

// *****************************************************************************
// *****************************************************************************
// Section: Driver Configuration
// *****************************************************************************
// *****************************************************************************
#define DRV_CAN_DRIVER_MODE_STATIC 
// *****************************************************************************
/* I2C Driver Configuration Options
*/
#define DRV_I2C_INTERRUPT_MODE                    		true
#define DRV_I2C_CLIENTS_NUMBER                    		1
#define DRV_I2C_INSTANCES_NUMBER                  		1

#define DRV_I2C_PERIPHERAL_ID_IDX0                		I2C_ID_2
#define DRV_I2C_OPERATION_MODE_IDX0               		DRV_I2C_MODE_MASTER
#define DRV_SCL_PORT_IDX0                               PORT_CHANNEL_A
#define DRV_SCL_PIN_POSITION_IDX0                       PORTS_BIT_POS_2
#define DRV_SDA_PORT_IDX0                               PORT_CHANNEL_A
#define DRV_SDA_PIN_POSITION_IDX0                       PORTS_BIT_POS_3
#define DRV_I2C_BIT_BANG_IDX0                           false
#define DRV_I2C_STOP_IN_IDLE_IDX0                       false
#define DRV_I2C_SMBus_SPECIFICATION_IDX0			    false
#define DRV_I2C_BAUD_RATE_IDX0                    		400000
#define DRV_I2C_BRG_CLOCK_IDX0	                  		80000000
#define DRV_I2C_SLEW_RATE_CONTROL_IDX0      			true
#define DRV_I2C_MASTER_INT_SRC_IDX0               		INT_SOURCE_I2C_2_MASTER
#define DRV_I2C_SLAVE_INT_SRC_IDX0                		
#define DRV_I2C_ERR_MX_INT_SRC_IDX0               		INT_SOURCE_I2C_2_ERROR
#define DRV_I2C_INT_VECTOR_IDX0                         INT_VECTOR_I2C2
#define DRV_I2C_ISR_VECTOR_IDX0                         _I2C_2_VECTOR
#define DRV_I2C_INT_PRIORITY_IDX0                 		INT_PRIORITY_LEVEL1
#define DRV_I2C_INT_SUB_PRIORITY_IDX0             		INT_SUBPRIORITY_LEVEL0
#define DRV_I2C_POWER_STATE_IDX0                  		SYS_MODULE_POWER_RUN_FULL
#define DRV_I2C_INTERRUPT_MODE                    		true

/*** Timer Driver Configuration ***/
#define DRV_TMR_INTERRUPT_MODE             true

/*** Timer Driver 0 Configuration ***/
#define DRV_TMR_PERIPHERAL_ID_IDX0          TMR_ID_1
#define DRV_TMR_INTERRUPT_SOURCE_IDX0       INT_SOURCE_TIMER_1
#define DRV_TMR_INTERRUPT_VECTOR_IDX0       INT_VECTOR_T1
#define DRV_TMR_ISR_VECTOR_IDX0             _TIMER_1_VECTOR
#define DRV_TMR_INTERRUPT_PRIORITY_IDX0     INT_PRIORITY_LEVEL4
#define DRV_TMR_INTERRUPT_SUB_PRIORITY_IDX0 INT_SUBPRIORITY_LEVEL2
#define DRV_TMR_CLOCK_SOURCE_IDX0           DRV_TMR_CLKSOURCE_INTERNAL
#define DRV_TMR_PRESCALE_IDX0               TMR_PRESCALE_VALUE_256
#define DRV_TMR_OPERATION_MODE_IDX0         DRV_TMR_OPERATION_MODE_16_BIT
#define DRV_TMR_ASYNC_WRITE_ENABLE_IDX0     false
#define DRV_TMR_POWER_STATE_IDX0            

 // *****************************************************************************
/* USART Driver Configuration Options
*/
#define DRV_USART_INSTANCES_NUMBER                  3
#define DRV_USART_CLIENTS_NUMBER                    3
#define DRV_USART_INTERRUPT_MODE                    true
#define DRV_USART_BYTE_MODEL_SUPPORT                true
#define DRV_USART_READ_WRITE_MODEL_SUPPORT          false
#define DRV_USART_BUFFER_QUEUE_SUPPORT              false

// *****************************************************************************
// *****************************************************************************
// Section: Middleware & Other Library Configuration
// *****************************************************************************
// *****************************************************************************

// *****************************************************************************
/* BSP Configuration Options
*/
#define BSP_OSC_FREQUENCY 8000000


// *****************************************************************************
// *****************************************************************************
// Section: Application Configuration
// *****************************************************************************
// *****************************************************************************
/*** Application Defined Pins ***/

/*** Functions for LED_STATUS_ pin ***/
#define LED_STATUS_Toggle() PLIB_PORTS_PinToggle(PORTS_ID_0, PORT_CHANNEL_G, PORTS_BIT_POS_14)
#define LED_STATUS_On() PLIB_PORTS_PinSet(PORTS_ID_0, PORT_CHANNEL_G, PORTS_BIT_POS_14)
#define LED_STATUS_Off() PLIB_PORTS_PinClear(PORTS_ID_0, PORT_CHANNEL_G, PORTS_BIT_POS_14)
#define LED_STATUS_StateGet() PLIB_PORTS_PinGetLatched(PORTS_ID_0, PORT_CHANNEL_G, PORTS_BIT_POS_14)

/*** Functions for SDCARD_SS2_ pin ***/
#define SDCARD_SS2_Toggle() PLIB_PORTS_PinToggle(PORTS_ID_0, PORT_CHANNEL_G, PORTS_BIT_POS_9)
#define SDCARD_SS2_On() PLIB_PORTS_PinSet(PORTS_ID_0, PORT_CHANNEL_G, PORTS_BIT_POS_9)
#define SDCARD_SS2_Off() PLIB_PORTS_PinClear(PORTS_ID_0, PORT_CHANNEL_G, PORTS_BIT_POS_9)
#define SDCARD_SS2_StateGet() PLIB_PORTS_PinGetLatched(PORTS_ID_0, PORT_CHANNEL_G, PORTS_BIT_POS_9)
#define SDCARD_SS2_StateSet(Value) PLIB_PORTS_PinWrite(PORTS_ID_0, PORT_CHANNEL_G, PORTS_BIT_POS_9, Value)

/*** Functions for UART_5_EN_ pin ***/
#define UART_5_EN_Toggle() PLIB_PORTS_PinToggle(PORTS_ID_0, PORT_CHANNEL_A, PORTS_BIT_POS_1)
#define UART_5_EN_On() PLIB_PORTS_PinSet(PORTS_ID_0, PORT_CHANNEL_A, PORTS_BIT_POS_1)
#define UART_5_EN_Off() PLIB_PORTS_PinClear(PORTS_ID_0, PORT_CHANNEL_A, PORTS_BIT_POS_1)
#define UART_5_EN_StateGet() PLIB_PORTS_PinGetLatched(PORTS_ID_0, PORT_CHANNEL_A, PORTS_BIT_POS_1)
#define UART_5_EN_StateSet(Value) PLIB_PORTS_PinWrite(PORTS_ID_0, PORT_CHANNEL_A, PORTS_BIT_POS_1, Value)

/*** Functions for UART_2_EN_ pin ***/
#define UART_2_EN_Toggle() PLIB_PORTS_PinToggle(PORTS_ID_0, PORT_CHANNEL_F, PORTS_BIT_POS_3)
#define UART_2_EN_On() PLIB_PORTS_PinSet(PORTS_ID_0, PORT_CHANNEL_F, PORTS_BIT_POS_3)
#define UART_2_EN_Off() PLIB_PORTS_PinClear(PORTS_ID_0, PORT_CHANNEL_F, PORTS_BIT_POS_3)
#define UART_2_EN_StateGet() PLIB_PORTS_PinGetLatched(PORTS_ID_0, PORT_CHANNEL_F, PORTS_BIT_POS_3)
#define UART_2_EN_StateSet(Value) PLIB_PORTS_PinWrite(PORTS_ID_0, PORT_CHANNEL_F, PORTS_BIT_POS_3, Value)

/*** Functions for OUTPUT_2_ pin ***/
#define OUTPUT_2_Toggle() PLIB_PORTS_PinToggle(PORTS_ID_0, PORT_CHANNEL_D, PORTS_BIT_POS_1)
#define OUTPUT_2_On() PLIB_PORTS_PinSet(PORTS_ID_0, PORT_CHANNEL_D, PORTS_BIT_POS_1)
#define OUTPUT_2_Off() PLIB_PORTS_PinClear(PORTS_ID_0, PORT_CHANNEL_D, PORTS_BIT_POS_1)
#define OUTPUT_2_StateGet() PLIB_PORTS_PinGetLatched(PORTS_ID_0, PORT_CHANNEL_D, PORTS_BIT_POS_1)
#define OUTPUT_2_StateSet(Value) PLIB_PORTS_PinWrite(PORTS_ID_0, PORT_CHANNEL_D, PORTS_BIT_POS_1, Value)

/*** Functions for OUTPUT_1_ pin ***/
#define OUTPUT_1_Toggle() PLIB_PORTS_PinToggle(PORTS_ID_0, PORT_CHANNEL_D, PORTS_BIT_POS_2)
#define OUTPUT_1_On() PLIB_PORTS_PinSet(PORTS_ID_0, PORT_CHANNEL_D, PORTS_BIT_POS_2)
#define OUTPUT_1_Off() PLIB_PORTS_PinClear(PORTS_ID_0, PORT_CHANNEL_D, PORTS_BIT_POS_2)
#define OUTPUT_1_StateGet() PLIB_PORTS_PinGetLatched(PORTS_ID_0, PORT_CHANNEL_D, PORTS_BIT_POS_2)
#define OUTPUT_1_StateSet(Value) PLIB_PORTS_PinWrite(PORTS_ID_0, PORT_CHANNEL_D, PORTS_BIT_POS_2, Value)

/*** Functions for ETH_RESET_ pin ***/
#define ETH_RESET_Toggle() PLIB_PORTS_PinToggle(PORTS_ID_0, PORT_CHANNEL_E, PORTS_BIT_POS_2)
#define ETH_RESET_On() PLIB_PORTS_PinSet(PORTS_ID_0, PORT_CHANNEL_E, PORTS_BIT_POS_2)
#define ETH_RESET_Off() PLIB_PORTS_PinClear(PORTS_ID_0, PORT_CHANNEL_E, PORTS_BIT_POS_2)
#define ETH_RESET_StateGet() PLIB_PORTS_PinGetLatched(PORTS_ID_0, PORT_CHANNEL_E, PORTS_BIT_POS_2)
#define ETH_RESET_StateSet(Value) PLIB_PORTS_PinWrite(PORTS_ID_0, PORT_CHANNEL_E, PORTS_BIT_POS_2, Value)

/*** Functions for ETH_RELOAD_ pin ***/
#define ETH_RELOAD_Toggle() PLIB_PORTS_PinToggle(PORTS_ID_0, PORT_CHANNEL_E, PORTS_BIT_POS_3)
#define ETH_RELOAD_On() PLIB_PORTS_PinSet(PORTS_ID_0, PORT_CHANNEL_E, PORTS_BIT_POS_3)
#define ETH_RELOAD_Off() PLIB_PORTS_PinClear(PORTS_ID_0, PORT_CHANNEL_E, PORTS_BIT_POS_3)
#define ETH_RELOAD_StateGet() PLIB_PORTS_PinGetLatched(PORTS_ID_0, PORT_CHANNEL_E, PORTS_BIT_POS_3)
#define ETH_RELOAD_StateSet(Value) PLIB_PORTS_PinWrite(PORTS_ID_0, PORT_CHANNEL_E, PORTS_BIT_POS_3, Value)

/*** Functions for ETH_ENABLE_ pin ***/
#define ETH_ENABLE_Toggle() PLIB_PORTS_PinToggle(PORTS_ID_0, PORT_CHANNEL_E, PORTS_BIT_POS_4)
#define ETH_ENABLE_On() PLIB_PORTS_PinSet(PORTS_ID_0, PORT_CHANNEL_E, PORTS_BIT_POS_4)
#define ETH_ENABLE_Off() PLIB_PORTS_PinClear(PORTS_ID_0, PORT_CHANNEL_E, PORTS_BIT_POS_4)
#define ETH_ENABLE_StateGet() PLIB_PORTS_PinGetLatched(PORTS_ID_0, PORT_CHANNEL_E, PORTS_BIT_POS_4)
#define ETH_ENABLE_StateSet(Value) PLIB_PORTS_PinWrite(PORTS_ID_0, PORT_CHANNEL_E, PORTS_BIT_POS_4, Value)

/*** Functions for INPUT_6_ pin ***/
#define INPUT_6_StateGet() PLIB_PORTS_PinGet(PORTS_ID_0, PORT_CHANNEL_B, PORTS_BIT_POS_4)

/*** Functions for INPUT_5_ pin ***/
#define INPUT_5_StateGet() PLIB_PORTS_PinGet(PORTS_ID_0, PORT_CHANNEL_B, PORTS_BIT_POS_3)

/*** Functions for INPUT_4_ pin ***/
#define INPUT_4_StateGet() PLIB_PORTS_PinGet(PORTS_ID_0, PORT_CHANNEL_B, PORTS_BIT_POS_2)

/*** Functions for INPUT_3_ pin ***/
#define INPUT_3_StateGet() PLIB_PORTS_PinGet(PORTS_ID_0, PORT_CHANNEL_B, PORTS_BIT_POS_1)

/*** Functions for INPUT_2_ pin ***/
#define INPUT_2_StateGet() PLIB_PORTS_PinGet(PORTS_ID_0, PORT_CHANNEL_B, PORTS_BIT_POS_0)

/*** Functions for INPUT_1_ pin ***/
#define INPUT_1_StateGet() PLIB_PORTS_PinGet(PORTS_ID_0, PORT_CHANNEL_D, PORTS_BIT_POS_11)

/*** Functions for MPF_OUT_ pin ***/
#define MPF_OUT_StateGet() PLIB_PORTS_PinGet(PORTS_ID_0, PORT_CHANNEL_G, PORTS_BIT_POS_13)


/*** Application Instance 0 Configuration ***/

//DOM-IGNORE-BEGIN
#ifdef __cplusplus
}
#endif
//DOM-IGNORE-END

#endif // _SYSTEM_CONFIG_H
/*******************************************************************************
 End of File
*/
