erdemts/CanGateway/firmware/src/system_config/innoGateway2_base/system_init.c

/*******************************************************************************
  System Initialization File

  File Name:
    system_init.c

  Summary:
    This file contains source code necessary to initialize the system.

  Description:
    This file contains source code necessary to initialize the system.  It
    implements the "SYS_Initialize" function, defines the configuration bits,
    and allocates any necessary global system resources, such as the
    sysObj structure that contains the object handles to all the MPLAB Harmony
    module objects in the system.
 *******************************************************************************/

// DOM-IGNORE-BEGIN
/*******************************************************************************
Copyright (c) 2013-2015 released Microchip Technology Inc.  All rights reserved.

Microchip licenses to you the right to use, modify, copy and distribute
Software only when embedded on a Microchip microcontroller or digital signal
controller that is integrated into your product or third party product
(pursuant to the sublicense terms in the accompanying license agreement).

You should refer to the license agreement accompanying this Software for
additional information regarding your rights and obligations.

SOFTWARE AND DOCUMENTATION ARE PROVIDED AS IS WITHOUT WARRANTY OF ANY KIND,
EITHER EXPRESS OR IMPLIED, INCLUDING WITHOUT LIMITATION, ANY WARRANTY OF
MERCHANTABILITY, TITLE, NON-INFRINGEMENT AND FITNESS FOR A PARTICULAR PURPOSE.
IN NO EVENT SHALL MICROCHIP OR ITS LICENSORS BE LIABLE OR OBLIGATED UNDER
CONTRACT, NEGLIGENCE, STRICT LIABILITY, CONTRIBUTION, BREACH OF WARRANTY, OR
OTHER LEGAL EQUITABLE THEORY ANY DIRECT OR INDIRECT DAMAGES OR EXPENSES
INCLUDING BUT NOT LIMITED TO ANY INCIDENTAL, SPECIAL, INDIRECT, PUNITIVE OR
CONSEQUENTIAL DAMAGES, LOST PROFITS OR LOST DATA, COST OF PROCUREMENT OF
SUBSTITUTE GOODS, TECHNOLOGY, SERVICES, OR ANY CLAIMS BY THIRD PARTIES
(INCLUDING BUT NOT LIMITED TO ANY DEFENSE THEREOF), OR OTHER SIMILAR COSTS.
 *******************************************************************************/
// DOM-IGNORE-END

// *****************************************************************************
// *****************************************************************************
// Section: Included Files
// *****************************************************************************
// *****************************************************************************

#include "system_config.h"
#include "system_definitions.h"


// ****************************************************************************
// ****************************************************************************
// Section: Configuration Bits
// ****************************************************************************
// ****************************************************************************
// <editor-fold defaultstate="collapsed" desc="Configuration Bits">

/*** DEVCFG0 ***/

#pragma config DEBUG =      OFF
#pragma config ICESEL =     ICS_PGx2
#pragma config PWP =        OFF
#pragma config BWP =        OFF
#pragma config CP =         OFF

/*** DEVCFG1 ***/

#pragma config FNOSC =      PRIPLL
#pragma config FSOSCEN =    ON
#pragma config IESO =       ON
#pragma config POSCMOD =    XT
#pragma config OSCIOFNC =   OFF
#pragma config FPBDIV =     DIV_1
#pragma config FCKSM =      CSECMD
#pragma config WDTPS =      PS1048576
#pragma config FWDTEN =     ON
/*** DEVCFG2 ***/

#pragma config FPLLIDIV =   DIV_2
#pragma config FPLLMUL =    MUL_20
#pragma config FPLLODIV =   DIV_1
#pragma config UPLLIDIV =   DIV_2
#pragma config UPLLEN =     ON
/*** DEVCFG3 ***/

#pragma config USERID =     0xffff
#pragma config FSRSSEL =    PRIORITY_7
#pragma config FMIIEN =     OFF
#pragma config FETHIO =     ON
#pragma config FCANIO =     ON
#pragma config FUSBIDIO =   ON
#pragma config FVBUSONIO =  ON
// </editor-fold>

// *****************************************************************************
// *****************************************************************************
// Section: Driver Initialization Data
// *****************************************************************************
// *****************************************************************************
// <editor-fold defaultstate="collapsed" desc="DRV_I2C Initialization Data">
// *****************************************************************************
/* I2C Driver Initialization Data
*/

const DRV_I2C_INIT drvI2C0InitData =
{
    .i2cId = DRV_I2C_PERIPHERAL_ID_IDX0,
    .i2cMode = DRV_I2C_OPERATION_MODE_IDX0,
    .portSCL = DRV_SCL_PORT_IDX0,
	.pinSCL  = DRV_SCL_PIN_POSITION_IDX0,
	.portSDA = DRV_SDA_PORT_IDX0,
	.pinSDA  = DRV_SDA_PIN_POSITION_IDX0,
    .baudRate = DRV_I2C_BAUD_RATE_IDX0,
    .busspeed = DRV_I2C_SLEW_RATE_CONTROL_IDX0,
    .buslevel = DRV_I2C_SMBus_SPECIFICATION_IDX0,
    .mstrInterruptSource = DRV_I2C_MASTER_INT_SRC_IDX0,
    .errInterruptSource = DRV_I2C_ERR_MX_INT_SRC_IDX0,
};




// </editor-fold>
// <editor-fold defaultstate="collapsed" desc="DRV_Timer Initialization Data">
// </editor-fold>
// <editor-fold defaultstate="collapsed" desc="DRV_USART Initialization Data">
// </editor-fold>

// *****************************************************************************
// *****************************************************************************
// Section: System Data
// *****************************************************************************
// *****************************************************************************

/* Structure to hold the object handles for the modules in the system. */
SYSTEM_OBJECTS sysObj;

// *****************************************************************************
// *****************************************************************************
// Section: Module Initialization Data
// *****************************************************************************
// *****************************************************************************

// *****************************************************************************
// *****************************************************************************
// Section: Library/Stack Initialization Data
// *****************************************************************************
// *****************************************************************************

// *****************************************************************************
// *****************************************************************************
// Section: System Initialization
// *****************************************************************************
// *****************************************************************************

/*******************************************************************************
  Function:
    void SYS_Initialize ( void *data )

  Summary:
    Initializes the board, services, drivers, application and other modules.

  Remarks:
    See prototype in system/common/sys_module.h.
 */

void SYS_Initialize ( void* data )
{
    /* Core Processor Initialization */
    SYS_CLK_Initialize( NULL );
    SYS_DEVCON_Initialize(SYS_DEVCON_INDEX_0, (SYS_MODULE_INIT*)NULL);
    SYS_DEVCON_PerformanceConfig(SYS_CLK_SystemFrequencyGet());
    SYS_DEVCON_JTAGDisable();
    SYS_PORTS_Initialize();

    /* Board Support Package Initialization */
    BSP_Initialize();        

    /* Initialize Drivers */
    sysObj.drvI2C0 = DRV_I2C_Initialize(DRV_I2C_INDEX_0, (SYS_MODULE_INIT *)&drvI2C0InitData);


    SYS_INT_VectorPrioritySet(INT_VECTOR_I2C2, INT_PRIORITY_LEVEL1);
    SYS_INT_VectorSubprioritySet(INT_VECTOR_I2C2, INT_SUBPRIORITY_LEVEL0);


    /* Initialize CAN Driver 0 */
    DRV_CAN0_Initialize();

    /*Initialize TMR0 */
    DRV_TMR0_Initialize();
    DRV_TMR0_Start();
 
     sysObj.drvUsart0 = DRV_USART_Initialize(DRV_USART_INDEX_0, (SYS_MODULE_INIT *)NULL);
    sysObj.drvUsart1 = DRV_USART_Initialize(DRV_USART_INDEX_1, (SYS_MODULE_INIT *)NULL);
    sysObj.drvUsart2 = DRV_USART_Initialize(DRV_USART_INDEX_2, (SYS_MODULE_INIT *)NULL);
    SYS_INT_VectorPrioritySet(INT_VECTOR_UART1, INT_PRIORITY_LEVEL2);
    SYS_INT_VectorSubprioritySet(INT_VECTOR_UART1, INT_SUBPRIORITY_LEVEL0);
    SYS_INT_VectorPrioritySet(INT_VECTOR_UART2, INT_PRIORITY_LEVEL2);
    SYS_INT_VectorSubprioritySet(INT_VECTOR_UART2, INT_SUBPRIORITY_LEVEL0);
    SYS_INT_VectorPrioritySet(INT_VECTOR_UART5, INT_PRIORITY_LEVEL2);
    SYS_INT_VectorSubprioritySet(INT_VECTOR_UART5, INT_SUBPRIORITY_LEVEL0);

    /* Initialize System Services */

    /*** Interrupt Service Initialization Code ***/
    SYS_INT_Initialize();

    /* Initialize Middleware */

    /* Enable Global Interrupts */
    SYS_INT_Enable();

    /* Initialize the Application */
    APP_Initialize();
}


/*******************************************************************************
 End of File
*/
